knifter/pulsednmr/dist-client/README.TXT

This folder should contain:

 * ./env -> A (virtual, use miniconda) python 3 environment as a whole with:
	- python 3 (3.7)
	- matplotlib 3 (3.0.3)
	- PyQt 5 (5.9.2 with Qt 5.9.7)
	- numpy (1.16.2)
 * putty.exe
 * WinSCP.exe
