knifter/pulsednmr/Documentation/SwitchFilters_2019-06-03T15_28_03.pdf

## Measurement: Transmission / Reflection

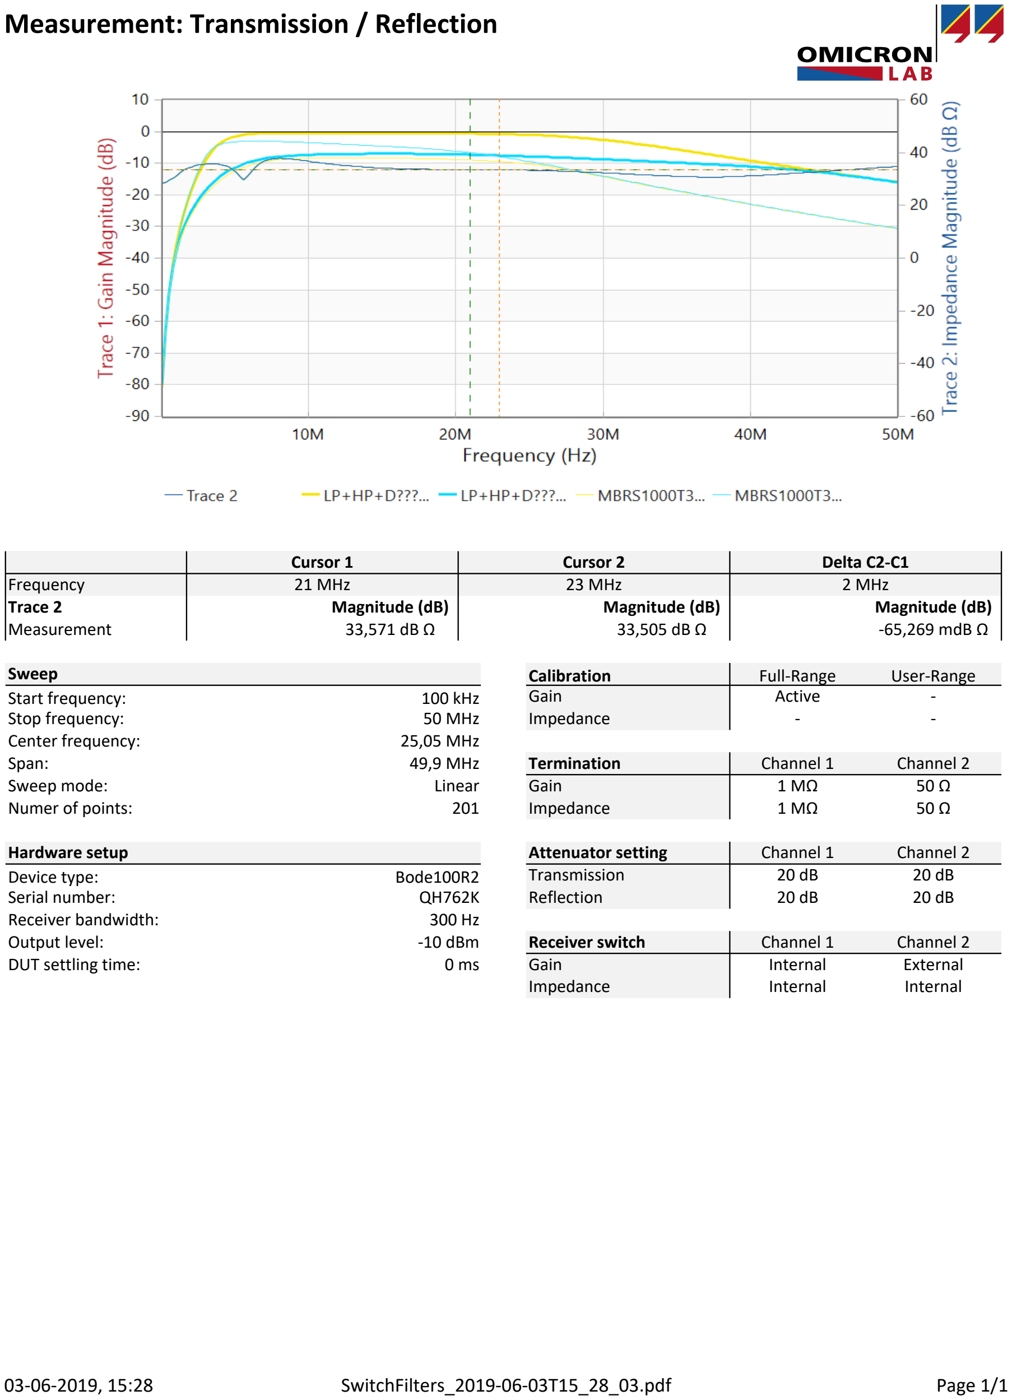
[picture p1: page 1]

03-06-2019, 15:28 | SwitchFilters_2019-06-03T15_28_03.pdf | Page 1/1
Cursor 1 | Cursor 2 | Delta C2-C1
Frequency | 21 MHz | 23 MHz | 2 MHz
Trace 2 | Magnitude (dB) | Magnitude (dB) | | Magnitude (dB)
Measurement | 33,571 dB Ω | 33,505 dB Ω | | -65,269 mdB Ω
Sweep | | Calibration | Full-Range | User-Range
Start frequency: | 100 kHz | Gain | Active | -
Stop frequency: | 50 MHz | Impedance | - | -
Center frequency: | 25,05 MHz
Span: | 49,9 MHz | Termination | Channel 1 | Channel 2
Sweep mode: | Linear | Gain | 1 MΩ | 50 Ω
Numer of points: | 201 | Impedance | 1 MΩ | 50 Ω
Hardware setup | | Attenuator setting | Channel 1 | Channel 2
Device type: | Bode100R2 | Transmission | 20 dB | 20 dB
Serial number: | QH762K | Reflection | 20 dB | 20 dB
Receiver bandwidth: | 300 Hz
Output level: | -10 dBm | Receiver switch | Channel 1 | Channel 2
DUT settling time: | 0 ms | Gain | Internal | External
| | Impedance | Internal | Internal
