knifter/pulsednmr/Bode/20N Packed, Spaced, Toroid_2019-05-02T14_10_56.pdf

## Measurement: Impedance Adapter

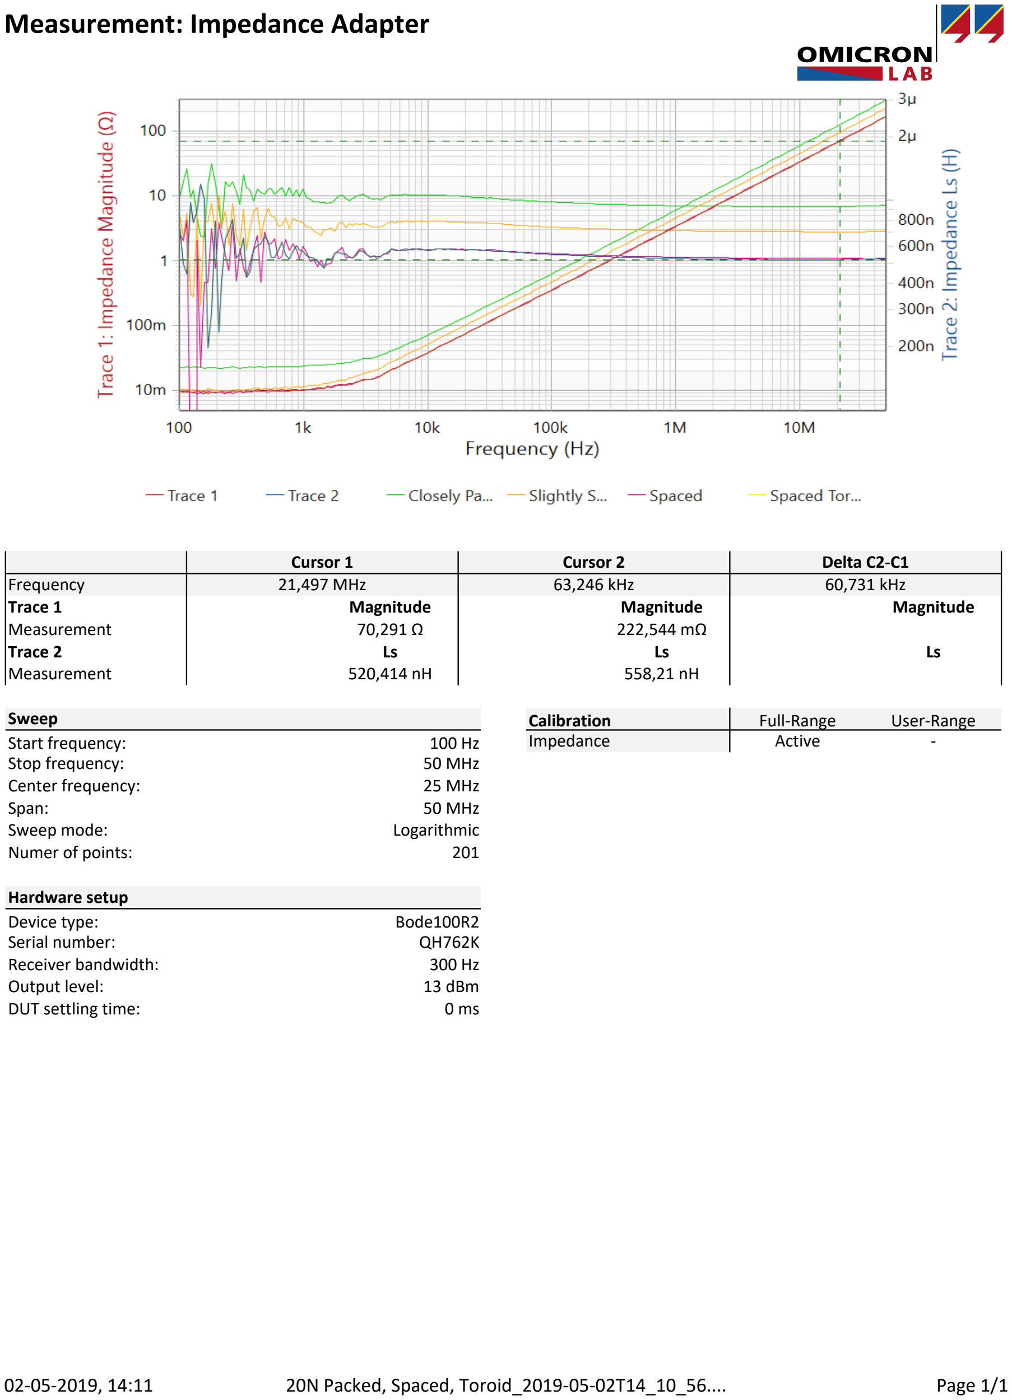
[picture p2: page 1]

02-05-2019, 14:11 | 20N Packed, Spaced, Toroid_2019-05-02T14_10_56.... | Page 1/1
Cursor 1 | Cursor 2 | Delta C2-C1
Frequency | 21,497 MHz | 63,246 kHz | 60,731 kHz
Trace 1 | Magnitude | Magnitude | Magnitude
Measurement | 70,291 Ω | 222,544 mΩ
Trace 2 | Ls | Ls | Ls
Measurement | 520,414 nH | 558,21 nH
Sweep | | Calibration | Full-Range | User-Range
Start frequency: | 100 Hz | Impedance | Active | -
Stop frequency: | 50 MHz
Center frequency: | 25 MHz
Span: | 50 MHz
Sweep mode: | Logarithmic
Numer of points: | 201

Hardware setup
Device type: | Bode100R2
Serial number: | QH762K
Receiver bandwidth: | 300 Hz
Output level: | 13 dBm
DUT settling time: | 0 ms
