knifter/pulsednmr/Bode/20N Packed, Spaced, Toroid_2019-05-02T14_21_03.pdf

## Measurement: Impedance Adapter

Page 1 / 3 | 20N Packed, Spaced, Toroid_2019-05-02T14_21_03.... | 02-05-2019 - 14:21

<!#auto page breaks>
CursorTable: Trace Version Wide | x
Cursor 1 | Cursor 2 | Delta C2-C1
Trace 1 | Magnitude | Magnitude | Magnitude
Measurement | 70,291 Ω | 222,544 mΩ
Trace 2 | Ls | Ls | Ls
Measurement | 520,414 nH | 558,21 nH
Cursor 1 | Cursor 2 | Delta C2-C1
Frequency | 21,497 MHz | | 63,246 kHz | | 60,731 kHz
Measurement | | 70,291 Ω | | 222,544 mΩ
Trace 2 | | Ls | | Ls | | Ls
Measurement | | 520,414 nH | | 558,21 nH
Trace 1 | Magnitude | Magnitude | Magnitude

Settings
Sweep
Start frequency: | 100 Hz
Stop frequency: | 50 MHz
Center frequency: | 25 MHz
Span: | 50 MHz
Sweep mode: | Logarithmic
Numer of points: | 201

Hardware setup
Device type: | Bode100R2
Serial number: | QH762K
Receiver bandwidth: | 300 Hz
Output level: | 13 dBm
DUT settling time: | 0 ms

Single / FIXED
Measurement
Source frequency: | 100 kHz
Measurement: | Impedance
Grid: | Cartesian
Format | Values

Shaped Level (False)

Shaped level | Frequency | Delta | Output level

Page 2 / 3 | 20N Packed, Spaced, Toroid_2019-05-02T14_21_03.... | 02-05-2019 - 14:21

MeasurementModeInUse: Impedance

Attenuator setting | Channel 1 | Channel 2
Reflection | 0 dB | 0 dB | Receiver switch | Channel 1 | Channel 2
| | | Gain | External | External
Attenuator setting | Channel 1 | Channel 2
Transmission | 0 dB | 0 dB | Receiver switch | Channel 1 | Channel 2
| | | Impedance | External | External
Attenuator setting | Channel 1 | Channel 2
Reflection | 0 dB | 0 dB | Receiver switch | Channel 1 | Channel 2
| | | Gain | External | External
| | | Impedance | External | External
Attenuator setting | Channel 1 | Channel 2
Transmission | 0 dB | 0 dB
Reflection | 0 dB | 0 dB
| | | Termination | Channel 1 | Channel 2
| | | Gain | 1 MΩ | 1 MΩ
Probe factor | Channel 1 | Channel 2
Gain | 1: 1 | 1: 1 | Termination | Channel 1 | Channel 2
| | | Impedance | 1 MΩ | 1 MΩ
Probe factor | Channel 1 | Channel 2
Impedance | 1: 1 | 1: 1 | Termination | Channel 1 | Channel 2
| | | Gain | 1 MΩ | 1 MΩ
| | | Impedance | 1 MΩ | 1 MΩ
Probe factor | Channel 1 | Channel 2
Gain | 1: 1 | 1: 1
Impedance | 1: 1 | 1: 1

Calibration: MAIN & MULTI
Calibration | Full-Range | User-Range
Gain | - | -
Impedance | Active | -
Calibration | Full-Range | User-Range
Thru | - | -
O/S/L | Active | -

Calibration: MULTI or MAIN
Calibration | Full-Range | User-Range
Impedance | Active | -

Calibration: Extrapolated
GainFullExtrapolated:
ImpFullExtrapolated:
Calibration | Full-Range | User-Range
Impedance | Active | -

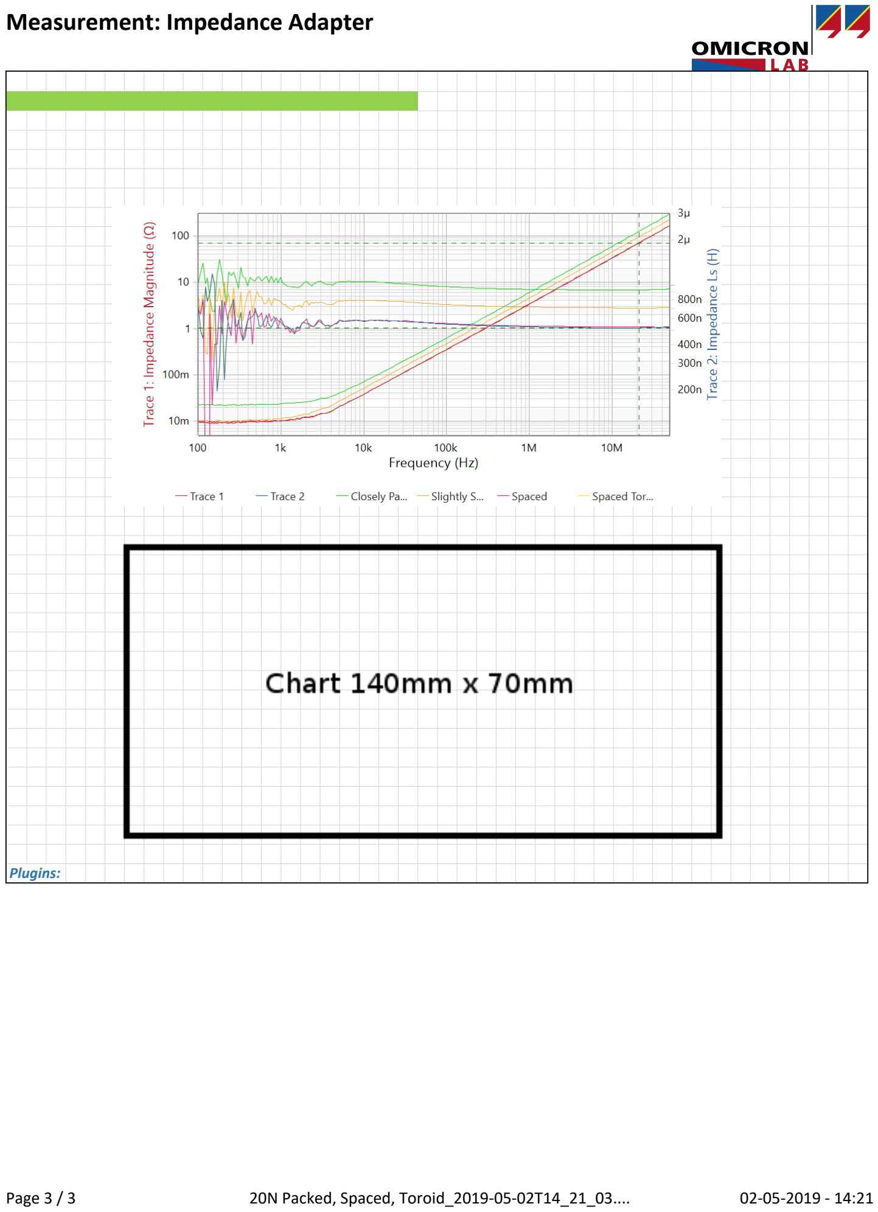
[picture p3: page 3]

Page 3 / 3 | 20N Packed, Spaced, Toroid_2019-05-02T14_21_03.... | 02-05-2019 - 14:21

Plugins:
