knifter/pulsednmr/Bode/20N Packed, Spaced, Toroid_2019-05-02T14_22_00.pdf

## Measurement: Impedance Adapter

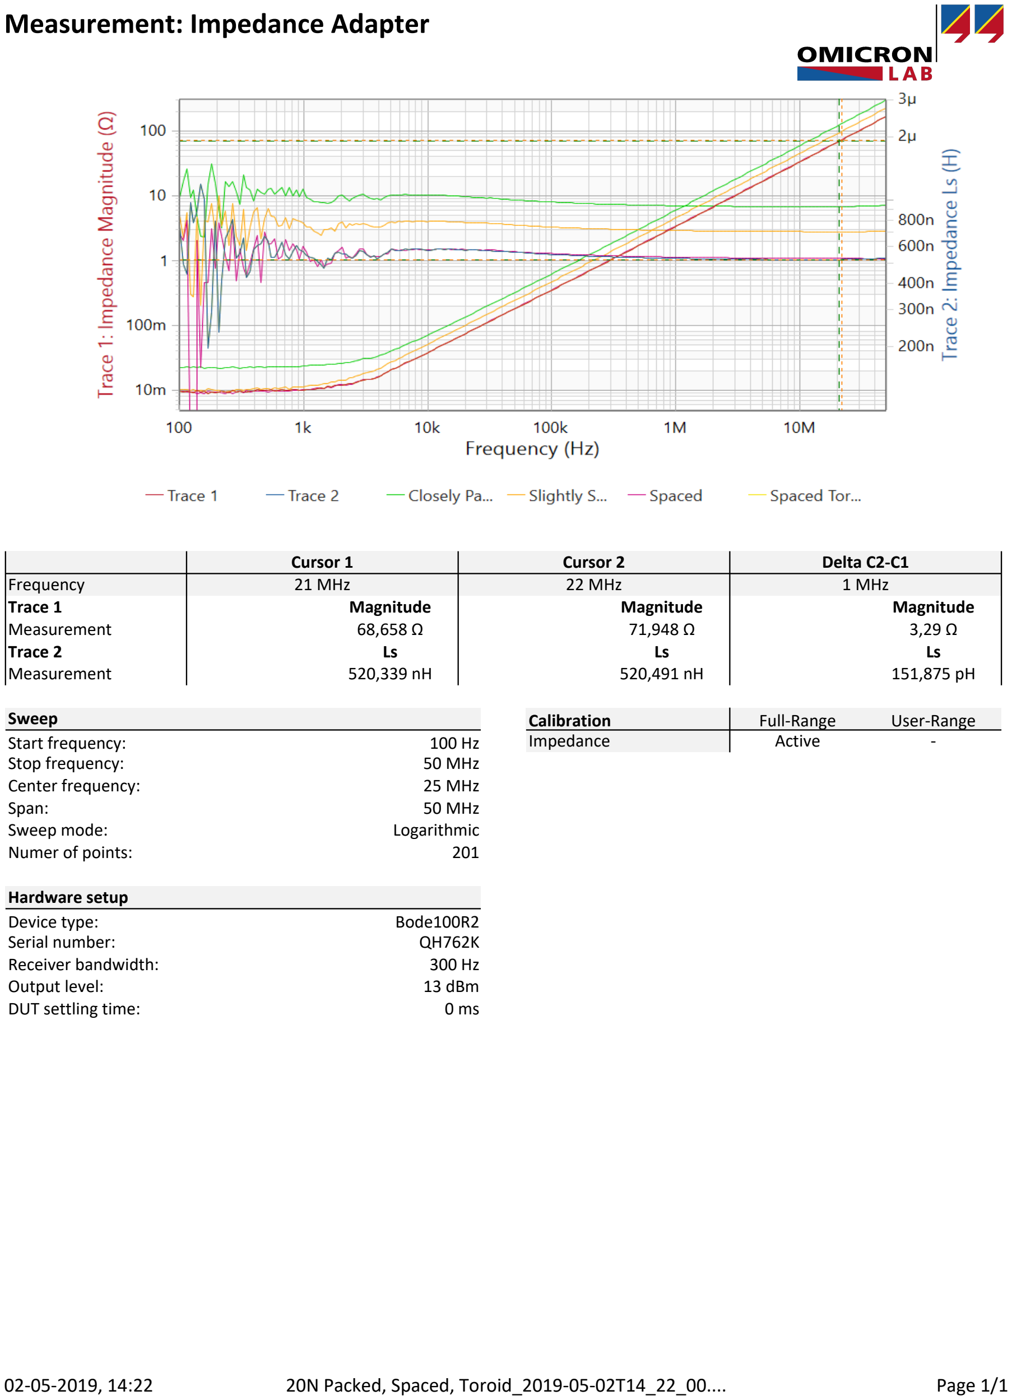
[picture p4: page 1]

02-05-2019, 14:22 | 20N Packed, Spaced, Toroid_2019-05-02T14_22_00.... | Page 1/1
Cursor 1 | Cursor 2 | Delta C2-C1
Frequency | 21 MHz | 22 MHz | 1 MHz
Trace 1 | Magnitude | Magnitude | Magnitude
Measurement | 68,658 Ω | 71,948 Ω | 3,29 Ω
Trace 2 | Ls | Ls | Ls
Measurement | 520,339 nH | 520,491 nH | 151,875 pH
Sweep | | Calibration | Full-Range | User-Range
Start frequency: | 100 Hz | Impedance | Active | -
Stop frequency: | 50 MHz
Center frequency: | 25 MHz
Span: | 50 MHz
Sweep mode: | Logarithmic
Numer of points: | 201

Hardware setup
Device type: | Bode100R2
Serial number: | QH762K
Receiver bandwidth: | 300 Hz
Output level: | 13 dBm
DUT settling time: | 0 ms
