knifter/pulsednmr/Bode/AMP1_2019-04-16b.pdf

## Measurement: Transmission / Reflection

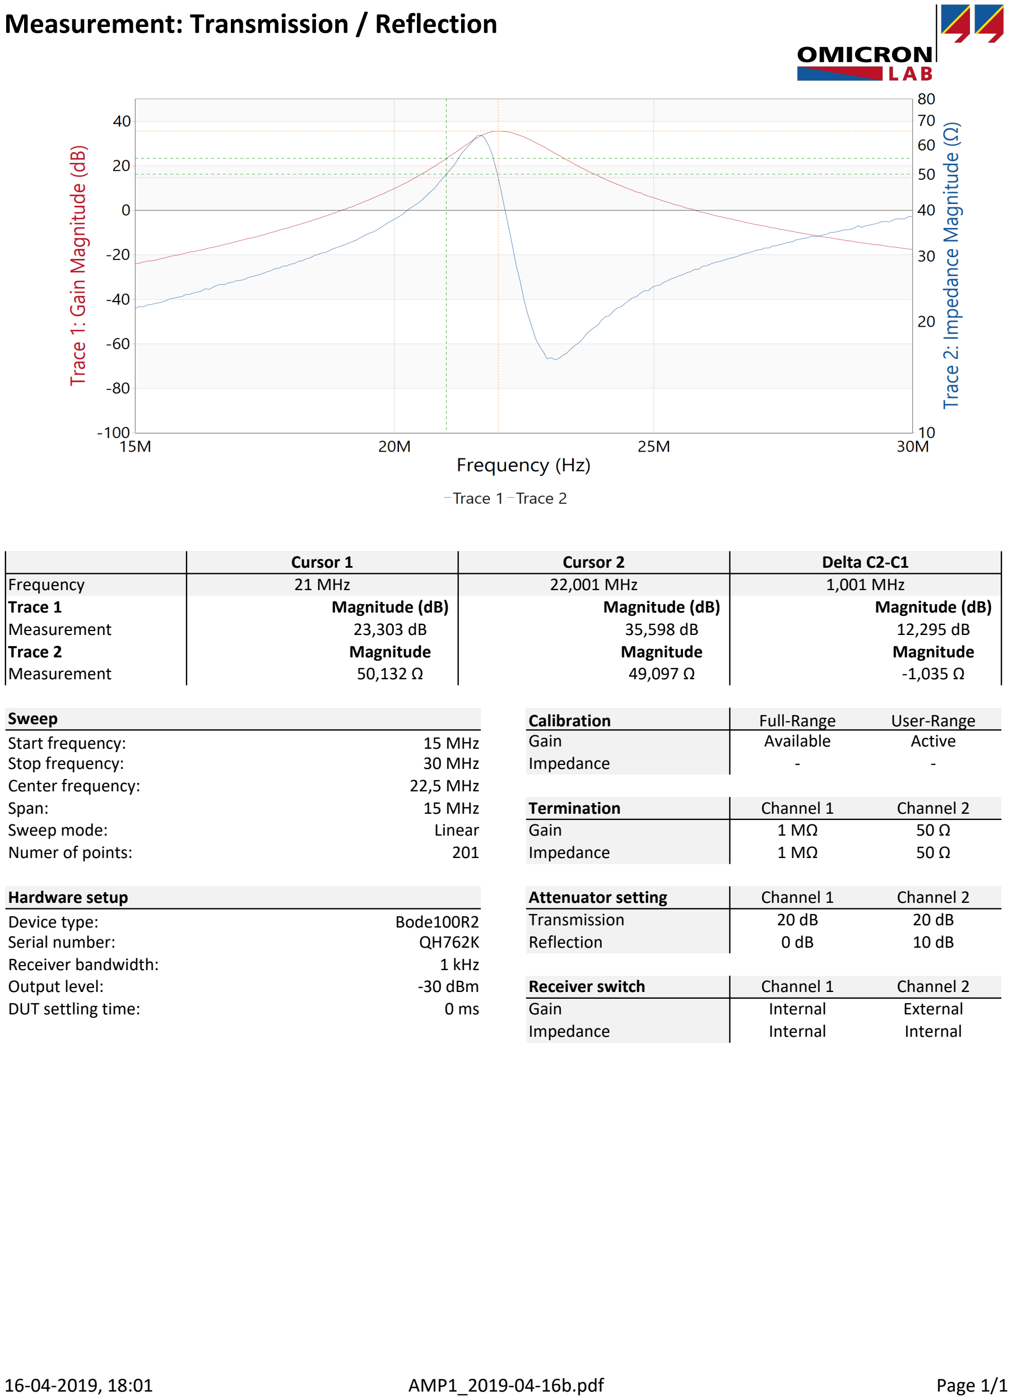
[picture p5: page 1]

16-04-2019, 18:01 | AMP1_2019-04-16b.pdf | Page 1/1
Cursor 1 | Cursor 2 | Delta C2-C1
Frequency | 21 MHz | 22,001 MHz | 1,001 MHz
Trace 1 | Magnitude (dB) | Magnitude (dB) | | Magnitude (dB)
Measurement | 23,303 dB | 35,598 dB | | 12,295 dB
Trace 2 | Magnitude | Magnitude | | Magnitude
Measurement | 50,132 Ω | 49,097 Ω | | -1,035 Ω
Sweep | | Calibration | Full-Range | User-Range
Start frequency: | 15 MHz | Gain | Available | Active
Stop frequency: | 30 MHz | Impedance | - | -
Center frequency: | 22,5 MHz
Span: | 15 MHz | Termination | Channel 1 | Channel 2
Sweep mode: | Linear | Gain | 1 MΩ | 50 Ω
Numer of points: | 201 | Impedance | 1 MΩ | 50 Ω
Hardware setup | | Attenuator setting | Channel 1 | Channel 2
Device type: | Bode100R2 | Transmission | 20 dB | 20 dB
Serial number: | QH762K | Reflection | 0 dB | 10 dB
Receiver bandwidth: | 1 kHz
Output level: | -30 dBm | Receiver switch | Channel 1 | Channel 2
DUT settling time: | 0 ms | Gain | Internal | External
| | Impedance | Internal | Internal
