knifter/pulsednmr/Bode/RF Amp 4W 2019-05-10.pdf

## Measurement: Transmission / Reflection

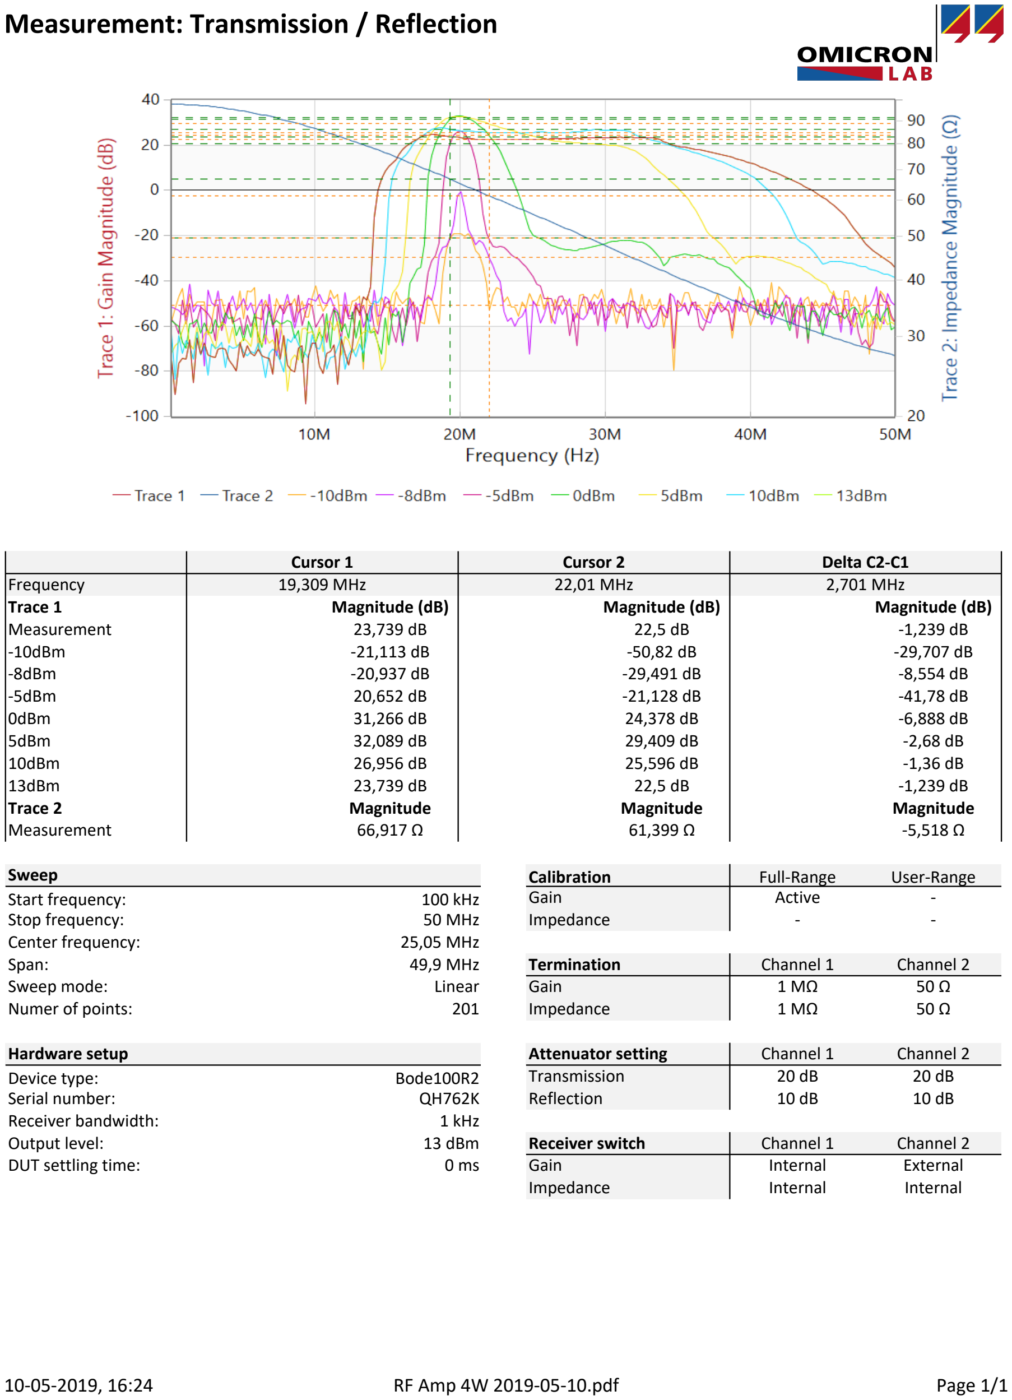
[picture p8: page 1]

10-05-2019, 16:24 | RF Amp 4W 2019-05-10.pdf | Page 1/1
Cursor 1 | Cursor 2 | Delta C2-C1
Frequency | 19,309 MHz | 22,01 MHz | 2,701 MHz
Trace 1 | Magnitude (dB) | Magnitude (dB) | | Magnitude (dB)
Measurement | 23,739 dB | 22,5 dB | | -1,239 dB
-10dBm | -21,113 dB | -50,82 dB | | -29,707 dB
-8dBm | -20,937 dB | -29,491 dB | | -8,554 dB
-5dBm | 20,652 dB | -21,128 dB | | -41,78 dB
0dBm | 31,266 dB | 24,378 dB | | -6,888 dB
5dBm | 32,089 dB | 29,409 dB | | -2,68 dB
10dBm | 26,956 dB | 25,596 dB | | -1,36 dB
13dBm | 23,739 dB | 22,5 dB | | -1,239 dB
Trace 2 | Magnitude | Magnitude | | Magnitude
Measurement | 66,917 Ω | 61,399 Ω | | -5,518 Ω
Sweep | | Calibration | Full-Range | User-Range
Start frequency: | 100 kHz | Gain | Active | -
Stop frequency: | 50 MHz | Impedance | - | -
Center frequency: | 25,05 MHz
Span: | 49,9 MHz | Termination | Channel 1 | Channel 2
Sweep mode: | Linear | Gain | 1 MΩ | 50 Ω
Numer of points: | 201 | Impedance | 1 MΩ | 50 Ω
Hardware setup | | Attenuator setting | Channel 1 | Channel 2
Device type: | Bode100R2 | Transmission | 20 dB | 20 dB
Serial number: | QH762K | Reflection | 10 dB | 10 dB
Receiver bandwidth: | 1 kHz
Output level: | 13 dBm | Receiver switch | Channel 1 | Channel 2
DUT settling time: | 0 ms | Gain | Internal | External
| | Impedance | Internal | Internal
