knifter/pulsednmr/(list of files, cad)

Other CAD files:
3D/PassiveSwitchCase.ipt
