knifter/pulsednmr/Documentation/Jason Allen-Poster.pdf

# Jason

# Allen

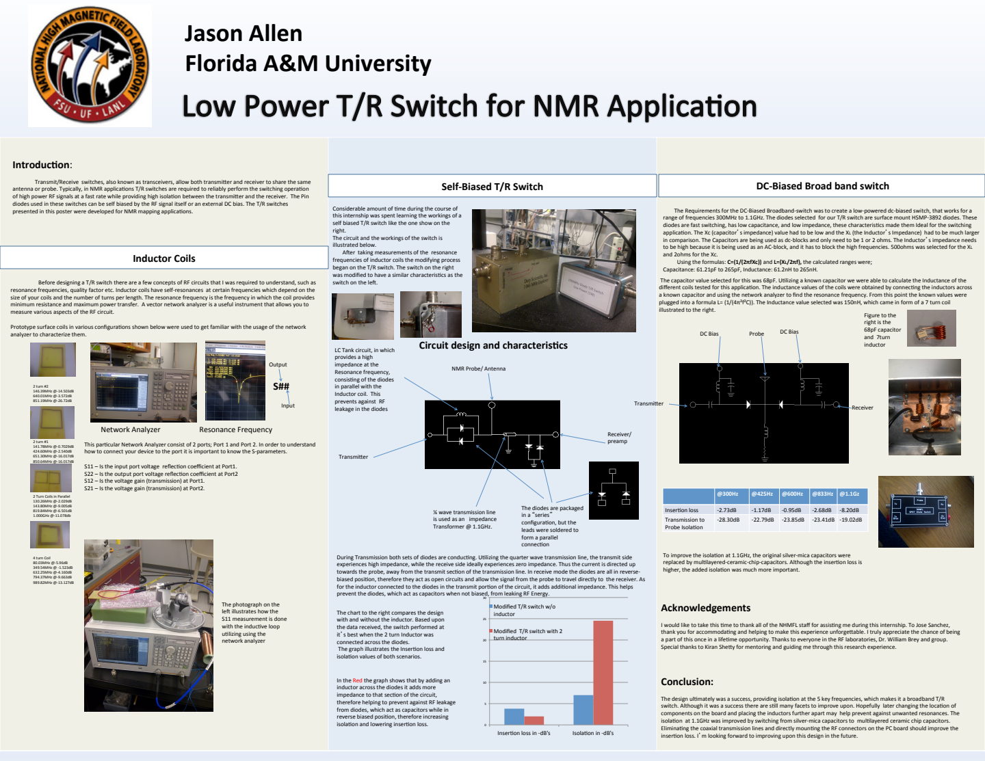
[picture p11: page 1]
Florida; University; Introduc7on:; Transmit/Receive; switches,; also; known; transceivers,; allow; both; transmi7er; and; receiver; share; the; same; antenna; probe.; Typically,; NMR; applica>ons; switches; are; required; reliably; perform; switching; opera>on; high; power; signals; fast; rate; while; providing; isola>on; between; receiver.; The; Pin; diodes; used; these; can; self; biased; signal; itself; external; bias.; presented; this; poster; were; developed; for; mapping; applica>ons.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

Insertion loss | -‐2.73dB | -‐1.17dB | -‐0.95dB | -‐2.68dB | -‐8.20dB
Transmission to Probe Isolation | -‐28.30dB | -‐22.79dB | -‐23.85dB | -‐23.41dB | -‐19.02dB

isolation
multilayered-‐ceramic-‐chip-‐capacitors.
