knifter/pulsednmr/Documentation/Red_Pitaya_Schematics_v1.0.1.pdf

1

2

3

4

5

6

D | D
B | B
C | C
A | A
Designer: B.B., B.R., Z.L. | Document: | Red_Pitaya_Schematics_v1.0.1 | Sheet 1 of 9
Drawn By: Z.L. | Modif. Date: | 6.3.2014 | SCHEMATIC
Approved By: R.U. | Print Date: | 6.3.2014 | Size: A4 H

# Red Pitaya

# Electrical schematics for:

# Red Pitaya

# version: variant: Release1

V1.0.1

Red Pitaya d.o.o.

# Velika pot 22 5250 Solkan Slovenia

# www.redpitaya.com

# name:

Copyright 2014, Red Pitaya d.o.o. All Rights Reserved.
By exception, this version of document may be freely reproduced, distributed, republished, displayed, posted, transmitted or copied in any form or by any means, as is without modifications in its contents, without the prior written permission of Red Pitaya d.o.o.
Red Pitaya and the Red Pitaya logo are registered trademarks of Red Pitaya d.o.o. All trademarks and trade names are the properties of their respective owners and Red Pitaya d.o.o. disclaims any proprietary interest or right in trademarks, service marks and trade names other than its own.
Red Pitaya is not responsible for typographical or other errors or omissions or for direct, indirect, incidental or consequential damages related to this material or resulting from its use.
Red Pitaya makes no warranty or representation respecting this material, which is provided on an "AS IS" basis.
RED PITAYA HEREBY DISCLAIMS ALL WARRANTIES OR LIABILITY OF ANY KIND WITH RESPECT THERETO, INCLUDING, WITHOUT LIMITATION, REPRESENTATIONS REGARDING ACCURACY AND COMPLETENESS, ALL IMPLIED WARRANTIES AND CONDITIONS OF MERCHANTABILITY, SUITABILITY OR FITNESS FOR A PARTICULAR PURPOSE, TITLE AND/OR NON-INFRINGEMENT.
This material is not designed, intended or authorized for use in any applications in which the failure of the product could result in personal injury, death or property damage.
Any party using or selling products for use in any such applications do so at their sole risk and agree that Red Pitaya is not liable, in whole or in part, for any claim or damage arising from such use, and agree to fully indemnify, defend and hold harmless Red Pitaya from and against any and all claims, damages, loss, cost, expense or liability arising out of or in connection with the use or performance of products in such applications.

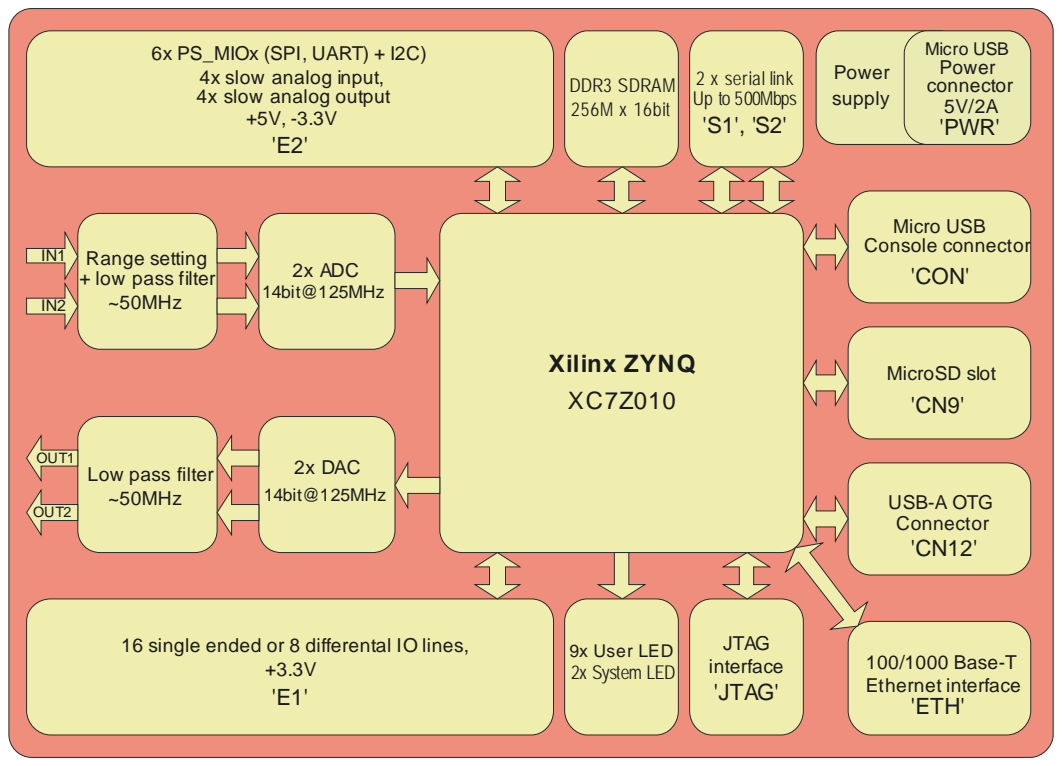
[picture p12: page 2]
DDR3 SDRAM 256M x 16bit; Range setting + low pass filter ~50MHz; 2x ADC 14bit@125MHz; Xilinx ZYNQ XC7Z010; Low pass filter ~50MHz; OUT1; OUT2; 2x DAC 14bit@125MHz; 2 x serial link Up to 500Mbps 'S1', 'S2'; Micro USB Console connector 'CON'; MicroSD slot 'CN9'; USB-A OTG Connector 'CN12'; 100/1000 Base-T Ethernet interface 'ETH'; JTAG; 'JTAG'; 9x User LED; 2x System LED; interface; supply; Power; Micro USB Power connector 5V/2A 'PWR'

6x PS_MIOx (SPI, UART) + I2C)
4x slow analog input,
4x slow analog output

16 single ended or 8 differental IO lines,

Designer: B.B., B.R., Z.L. | Document: | Red_Pitaya_Schematics_v1.0.1 | Sheet 2 of 9
Drawn By: Z.L. | Modif. Date: | 6.3.2014 | SCHEMATIC

Red Pitaya v1.0 block schematics

LV
IO_25_34 T19 | IO_L24N_T3_34 P16 | IO_L24P_T3_34 P15 | IO_L23N_T3_34 P18 | IO_L23P_T3_34 N17 | IO_L22N_T3_34 W19 | IO_L22P_T3_34 W18 | IO_L21N_T3_DQS_34 V18 | IO_L21P_T3_DQS_34 V17 | IO_L20N_T3_34 R18 | IO_L20P_T3_34 T17 | IO_L19N_T3_VREF_34 R17 | IO_L19P_T3_34 R16 | IO_L18N_T2_34 W16 | IO_L18P_T2_34 V16 | IO_L17N_T2_34 Y19 | IO_L17P_T2_34 Y18 | IO_L16N_T2_34 W20 | IO_L16P_T2_34 V20 | IO_L15N_T2_DQS_34 U20 | IO_L15P_T2_DQS_34 T20 | IO_L14N_T2_SRCC_34 P20 | IO_L14P_T2_SRCC_34 N20 | IO_L13N_T2_MRCC_34 P19 | IO_L13P_T2_MRCC_34 N18 | IO_L12N_T1_MRCC_34 U19 | IO_L12P_T1_MRCC_34 U18 | IO_L11N_T1_SRCC_34 U15 | IO_L11P_T1_SRCC_34 U14 | IO_L10N_T1_34 W15 | IO_L10P_T1_34 V15 | IO_L9N_T1_DQS_34 U17 | IO_L9P_T1_DQS_34 T16 | IO_L8N_T1_34 Y14 | IO_L8P_T1_34 W14 | IO_L7N_T1_34 Y17 | IO_L7P_T1_34 Y16 | IO_L6N_T0_VREF_34 R14 | IO_L6P_T0_34 P14 | IO_L5N_T0_34 T15 | IO_L5P_T0_34 T14 | IO_L4N_T0_34 W13 | IO_L4P_T0_34 V12 | IO_L3N_T0_DQS_34 V13 | IO_L3P_T0_DQS_PUDC_B_34 U13 | IO_L2N_T0_34 U12 | IO_L2P_T0_34 T12 | IO_L1N_T0_34 T10 | IO_L1P_T0_34 T11 | IO_0_34 R19

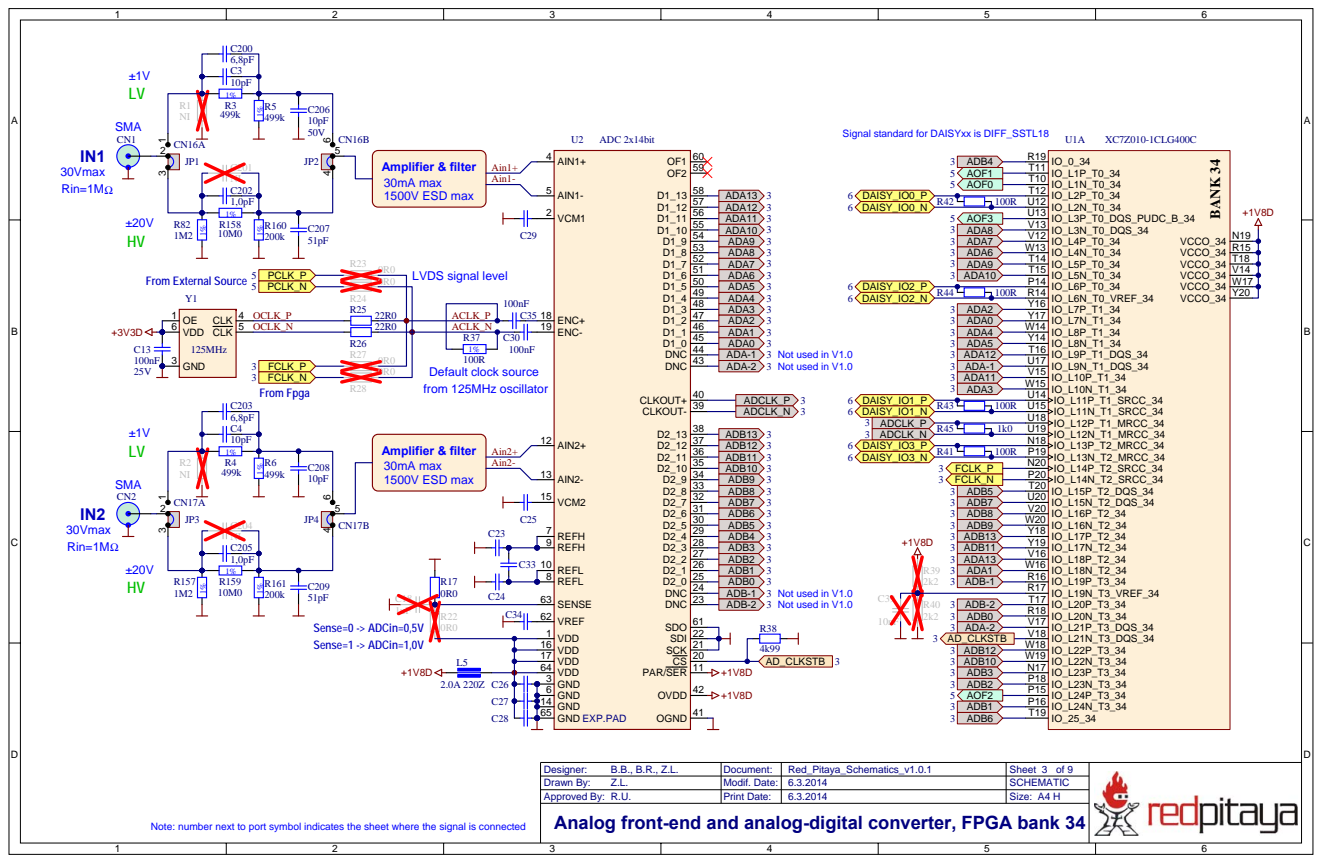
[picture p13: page 3]

Designer: B.B., B.R., Z.L. | Document: | Red_Pitaya_Schematics_v1.0.1 | Sheet 3 of 9
Drawn By: Z.L. | Modif. Date: | 6.3.2014 | SCHEMATIC

Analog front-end and analog-digital converter, FPGA bank 34

Note: number next to port symbol indicates the sheet where the signal is connected

IO_25_35 | J15 IO_L24N_T3_AD15N_35 | J16 IO_L24P_T3_AD15P_35 | K16 IO_L23N_T3_35 | M15 IO_L23P_T3_35 | M14 IO_L22N_T3_AD7N_35 | L15 IO_L22P_T3_AD7P_35 | L14 IO_L21N_T3_DQS_AD14N_35 | N16 IO_L21P_T3_DQS_AD14P_35 | N15 IO_L20N_T3_AD6N_35 | J14 IO_L20P_T3_AD6P_35 | K14 IO_L19N_T3_VREF_35 | G15 IO_L19P_T3_35 | H15 IO_L18N_T2_AD13N_35 | G20 IO_L18P_T2_AD13P_35 | G19 IO_L17N_T2_AD5N_35 | H20 IO_L17P_T2_AD5P_35 | J20 IO_L16N_T2_35 | G18 IO_L16P_T2_35 | G17 IO_L15N_T2_DQS_AD12N_35 | F20 IO_L15P_T2_DQS_AD12P_35 | F19 IO_L14N_T2_AD4N_SRCC_35 | H18 IO_L14P_T2_AD4P_SRCC_35 | J18 IO_L13N_T2_MRCC_35 | H17 IO_L13P_T2_MRCC_35 | H16 IO_L12N_T1_MRCC_35 | K18 IO_L12P_T1_MRCC_35 | K17 IO_L11N_T1_SRCC_35 | L17 IO_L11P_T1_SRCC_35 | L16 IO_L10N_T1_AD11N_35 | J19 IO_L10P_T1_AD11P_35 | K19 IO_L9N_T1_DQS_AD3N_35 | L20 IO_L9P_T1_DQS_AD3P_35 | L19 IO_L8N_T1_AD10N_35 | M18 IO_L8P_T1_AD10P_35 | M17 IO_L7N_T1_AD2N_35 | M20 IO_L7P_T1_AD2P_35 | M19 IO_L6N_T0_VREF_35 | F17 IO_L6P_T0_35 | F16 IO_L5N_T0_AD9N_35 | E19 IO_L5P_T0_AD9P_35 | E18 IO_L4N_T0_35 | D20 IO_L4P_T0_35 | D19 IO_L3N_T0_DQS_AD1N_35 | D18 IO_L3P_T0_DQS_AD1P_35 | E17 IO_L2N_T0_AD8N_35 | A20 IO_L2P_T0_AD8P_35 | B19 IO_L1N_T0_AD0N_35 | B20 IO_L1P_T0_AD0P_35 | C20 IO_0_35 | G14
DA1 13 | DA2 12 | DA3 11 | DA4 10 | DA5 9 | DA6 8 | DA7 7 | DA8 6 | DA9 5 | DA10 4 | DA11 3 | DA12 2 | DA13 1

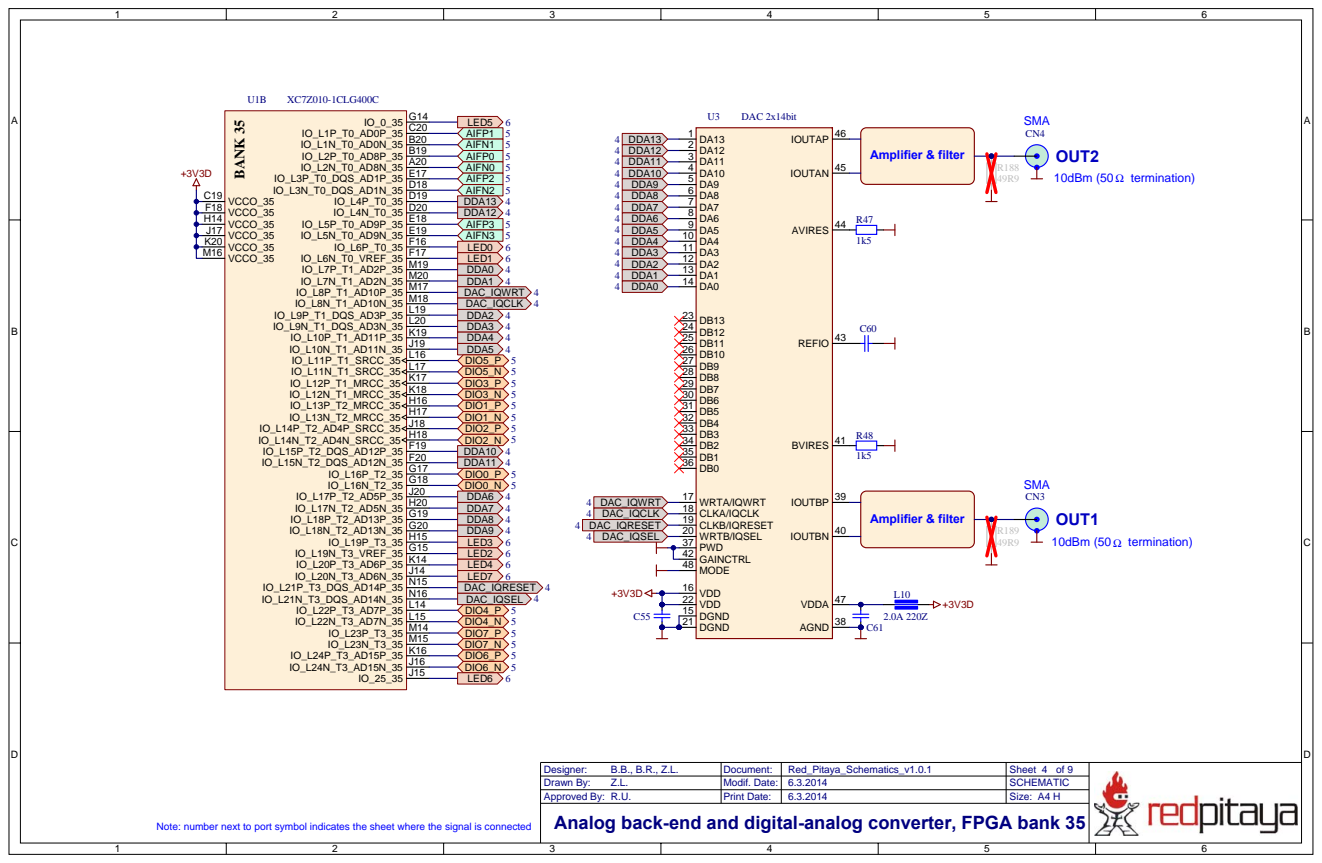
[picture p14: page 4]

Designer: B.B., B.R., Z.L. | Document: | Red_Pitaya_Schematics_v1.0.1 | Sheet 4 of 9
Drawn By: Z.L. | Modif. Date: | 6.3.2014 | SCHEMATIC

Analog back-end and digital-analog converter, FPGA bank 35

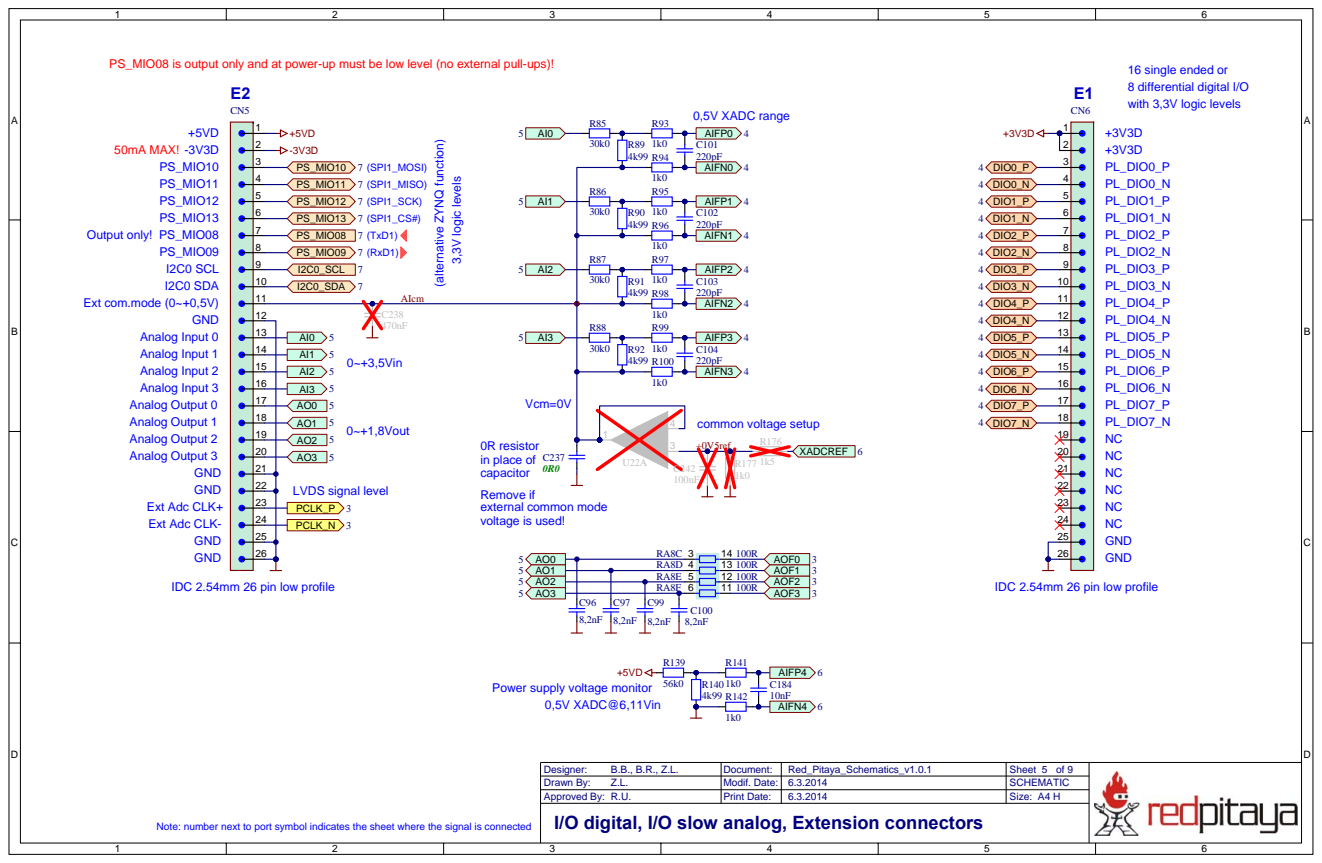
[picture p15: page 5]

with 3,3V logic levels 0,5V XADC range

Power supply voltage monitor

Designer: B.B., B.R., Z.L. | Document: | Red_Pitaya_Schematics_v1.0.1 | Sheet 5 of 9
Drawn By: Z.L. | Modif. Date: | 6.3.2014 | SCHEMATIC

I/O digital, I/O slow analog, Extension connectors

S1

## POW

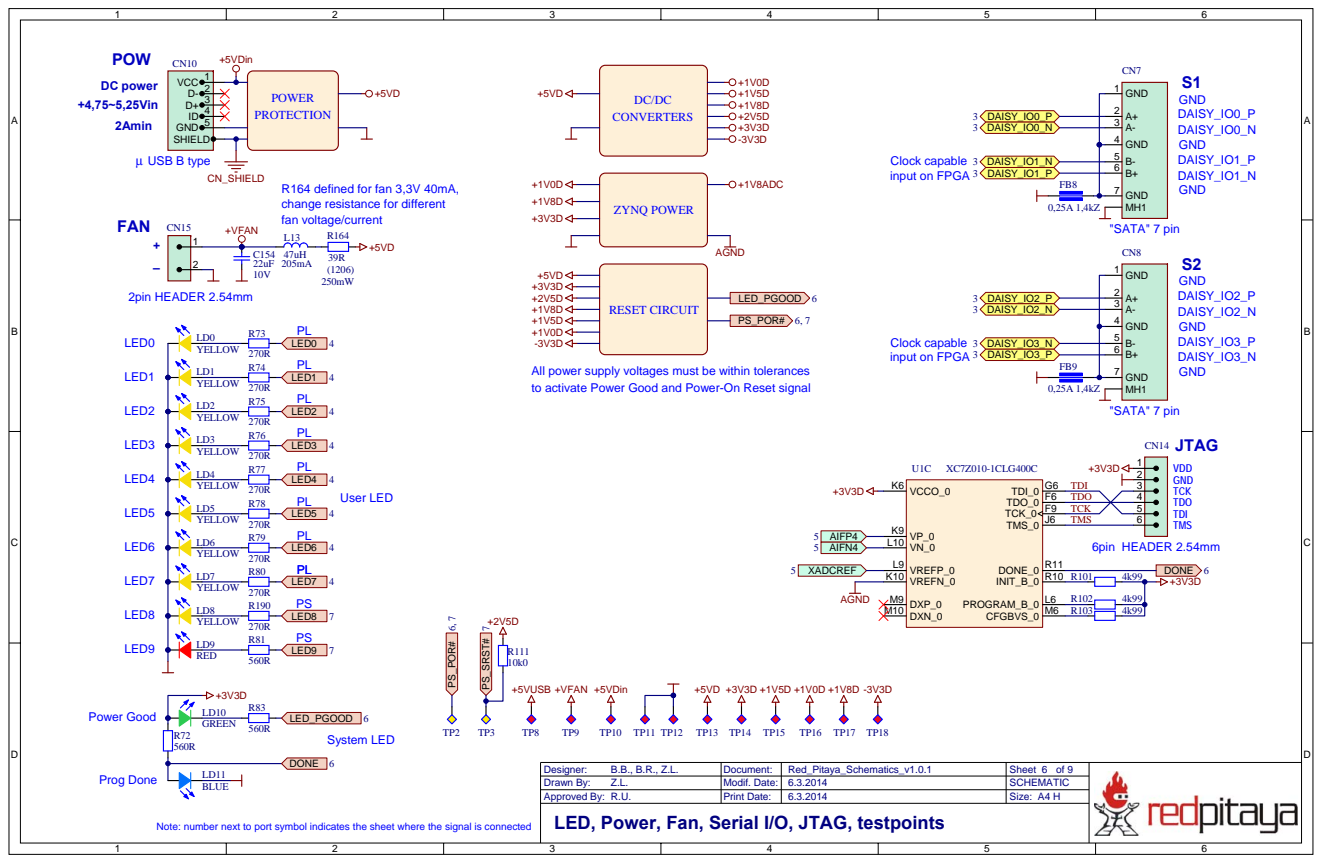
[picture p16: page 6]

R164 defined for fan 3,3V 40mA,
change resistance for different

All power supply voltages must be within tolerances
to activate Power Good and Power-On Reset signal

Designer: B.B., B.R., Z.L. | Document: | Red_Pitaya_Schematics_v1.0.1 | Sheet 6 of 9
Drawn By: Z.L. | Modif. Date: | 6.3.2014 | SCHEMATIC

LED, Power, Fan, Serial I/O, JTAG, testpoints

PS_MIO53_501 | C11 PS_MIO52_501 | C10 PS_MIO51_501 | B9 PS_MIO50_501 | B13 PS_MIO49_501 | C12 PS_MIO48_501 | B12 PS_MIO47_501 | B14 PS_MIO46_501 | D16 PS_MIO45_501 | B15 PS_MIO44_501 | F13 PS_MIO43_501 | A9 PS_MIO42_501 | E12 PS_MIO41_501 | C17 PS_MIO40_501 | D14 PS_MIO39_501 | C18 PS_MIO38_501 | E13 PS_MIO37_501 | A10 PS_MIO36_501 | A11 PS_MIO35_501 | F12 PS_MIO34_501 | A12 PS_MIO33_501 | D15 PS_MIO32_501 | A14 PS_MIO31_501 | E16 PS_MIO30_501 | C15 PS_MIO29_501 | C13 PS_MIO28_501 | C16 PS_MIO27_501 | D13 PS_MIO26_501 | A15 PS_MIO25_501 | F15 PS_MIO24_501 | A16 PS_MIO23_501 | D11 PS_MIO22_501 | B17 PS_MIO21_501 | F14 PS_MIO20_501 | A17 PS_MIO19_501 | D10 PS_MIO18_501 | B18 PS_MIO17_501 | E14 PS_MIO16_501 | A19 PS_MIO15_500 | C8 PS_MIO14_500 | C5 PS_MIO13_500 | E8 PS_MIO12_500 | D9 PS_MIO11_500 | C6 PS_MIO10_500 | E9 PS_MIO9_500 | B5 PS_MIO8_500 | D5 PS_MIO7_500 | D8 PS_MIO6_500 | A5 PS_MIO5_500 | A6 PS_MIO4_500 | B7 PS_MIO3_500 | D6 PS_MIO2_500 | B8 PS_MIO1_500 | A7 PS_MIO0_500 | E6

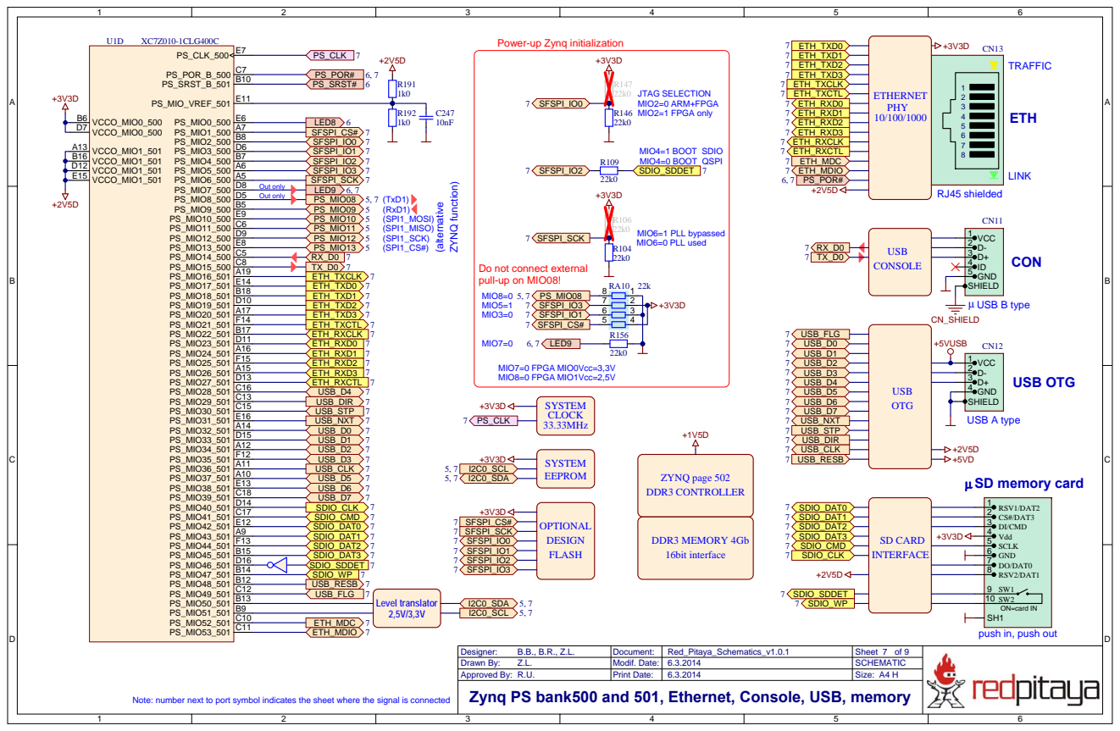
[picture p17: page 7]

Power-up Zynq initialization

Do not connect external
pull-up on MIO08!
MIO8=0

Designer: B.B., B.R., Z.L. | Document: | Red_Pitaya_Schematics_v1.0.1 | Sheet 7 of 9
Drawn By: Z.L. | Modif. Date: | 6.3.2014 | SCHEMATIC

Zynq PS bank500 and 501, Ethernet, Console, USB, memory

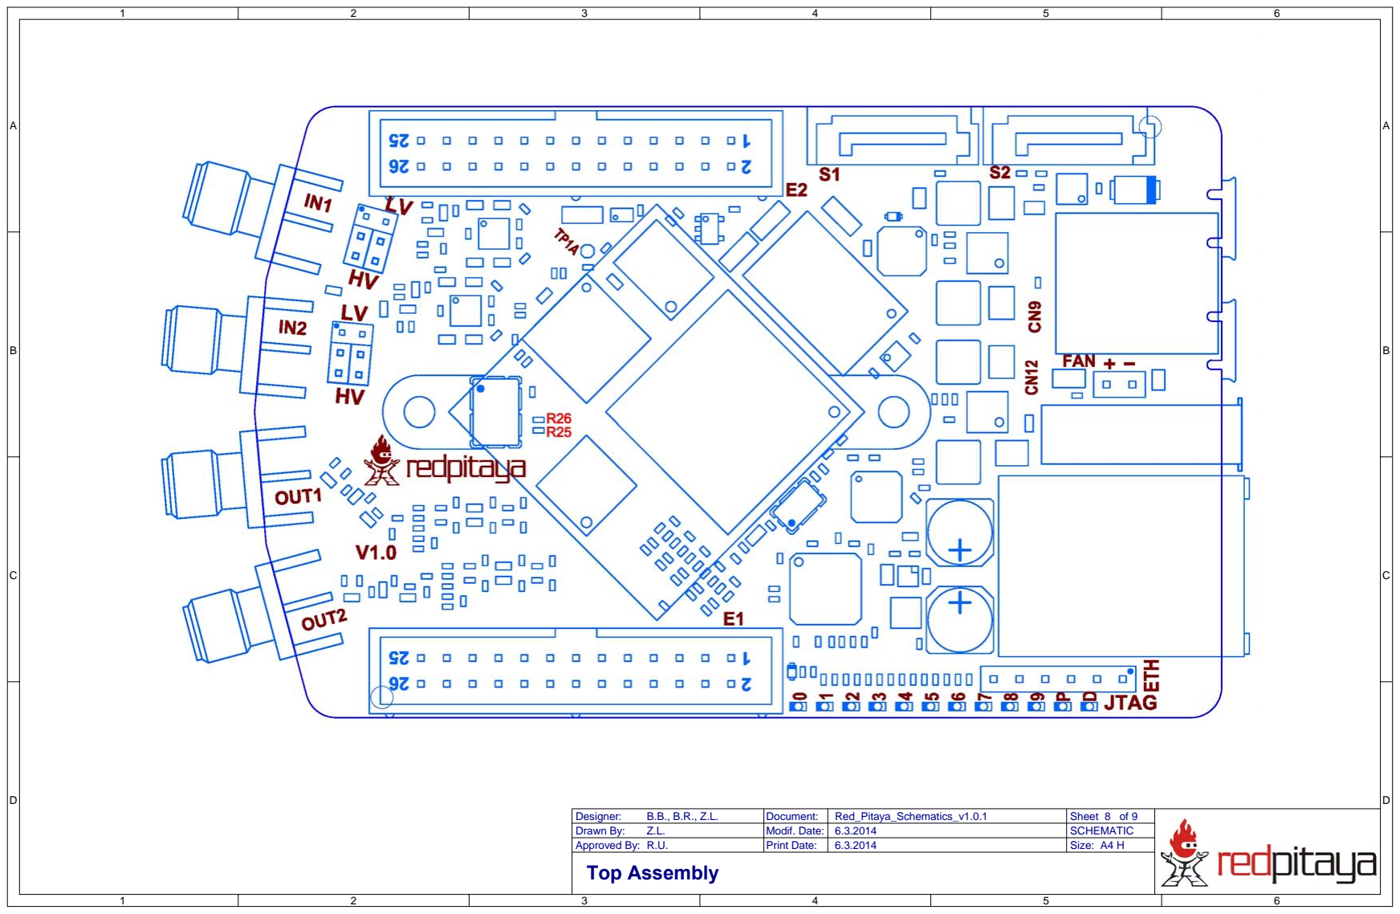
[picture p18: page 8]

1

2

3

4

5

6

D | D
B | B
C | C
A | A

# Top Assembly

Designer: B.B., B.R., Z.L. | Document: | Red_Pitaya_Schematics_v1.0.1 | Sheet 8 of 9
Drawn By: Z.L. | Modif. Date: | 6.3.2014 | SCHEMATIC

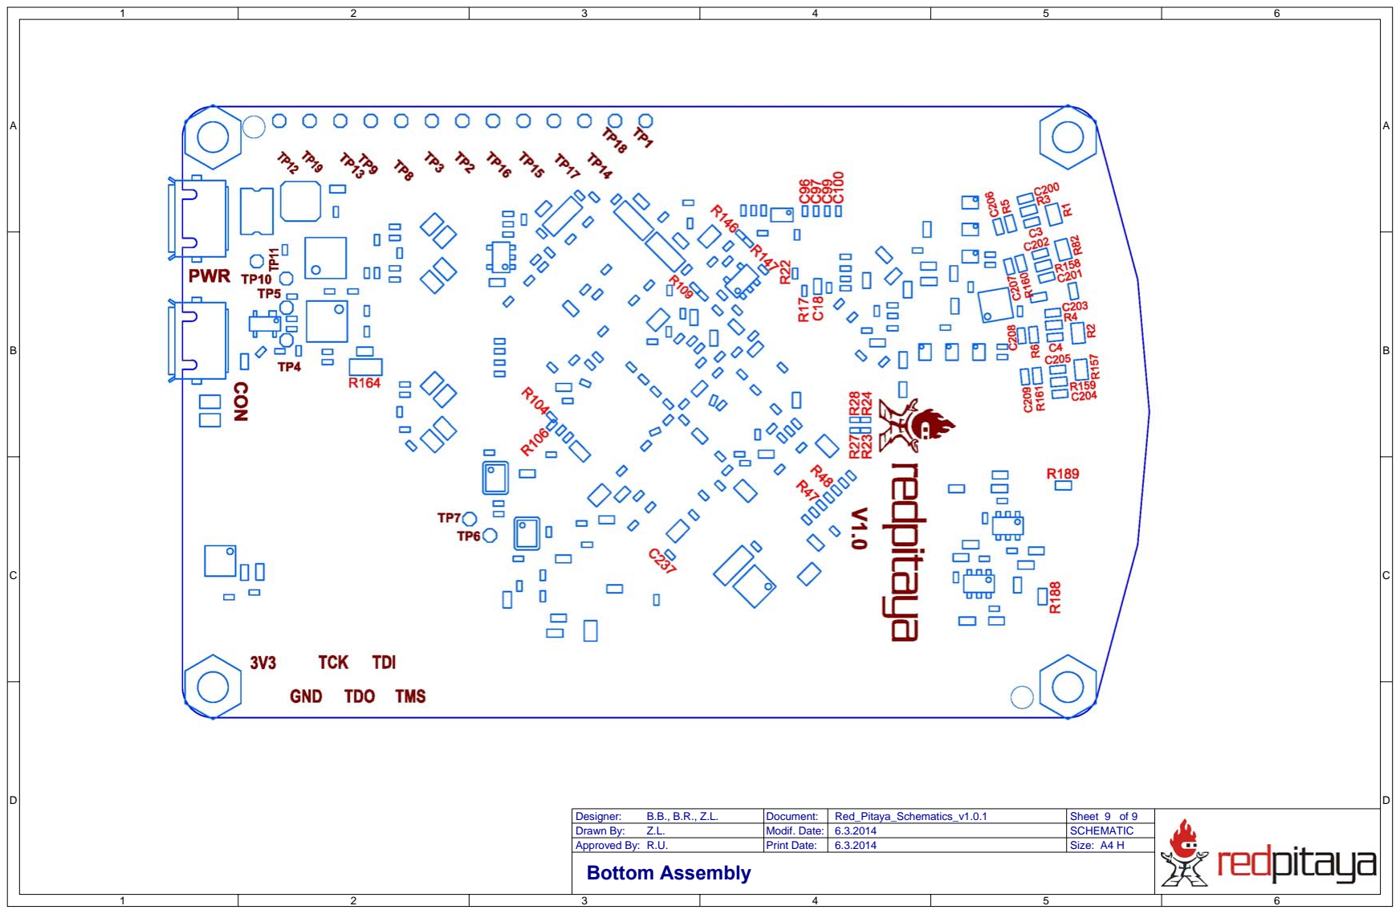
[picture p19: page 9]

1

2

3

4

5

6

D | D
B | B
C | C
A | A

# Bottom Assembly

Designer: B.B., B.R., Z.L. | Document: | Red_Pitaya_Schematics_v1.0.1 | Sheet 9 of 9
Drawn By: Z.L. | Modif. Date: | 6.3.2014 | SCHEMATIC
