knifter/pulsednmr/Documentation/Rplots.pdf

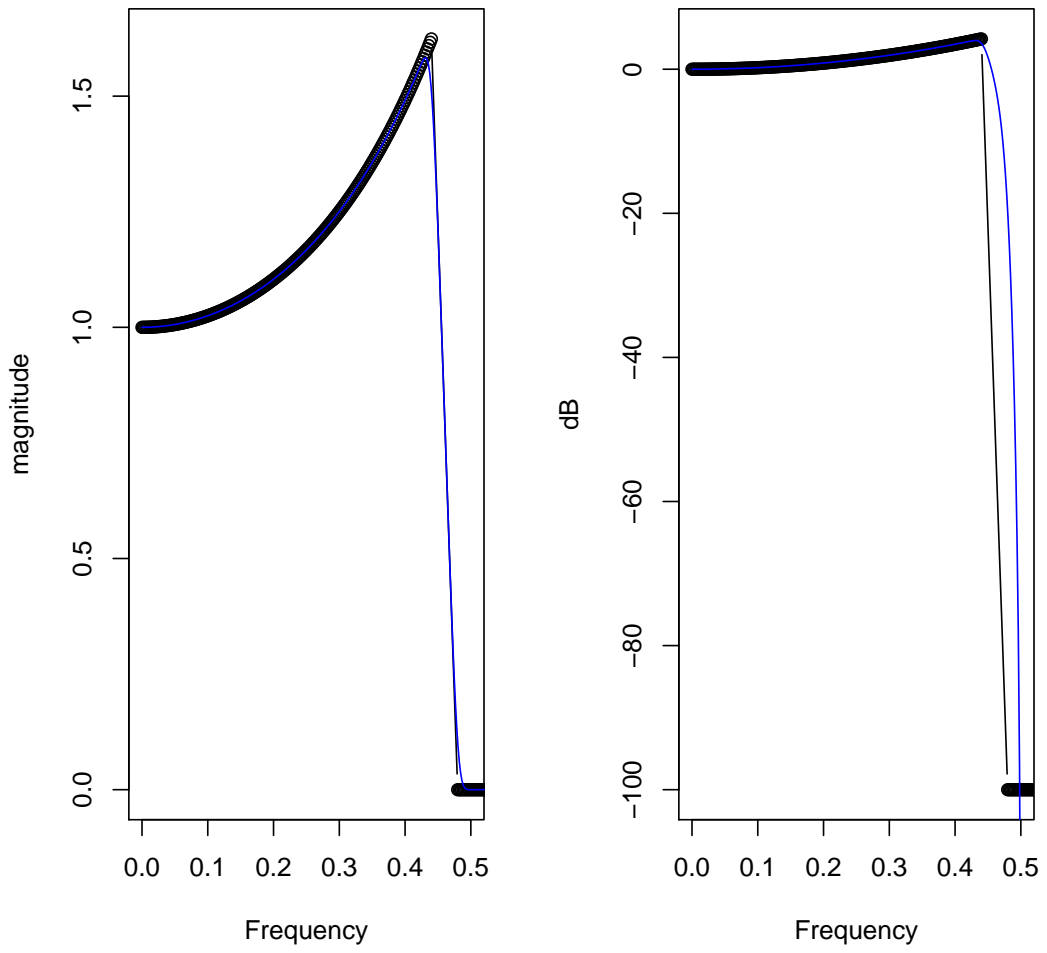
[picture p20: page 1]
Frequency; magnitude
