knifter/pulsednmr/Spice/22MHz Passive Switch and LNA.asc

C1: cap; 150p; Rser=0.1
C2: cap; 350p; Rser=0.1
C3: cap; 150p; Rser=0.1
C4: cap; 1n
C5: cap; 100n
C6: cap; 1µ
C7: cap; 1µ
C8: cap; 1µ
D1: diode; 1N4148
D2: diode; 1N4148
D3: diode; 1N4148
D4: diode; 1N4148
D5: diode; 1N4148
J1: njf; LS5912C
L1: ind; 360n; Rser=0.3
L2: ind; 1µ5; Rser=0.3
L3: ind; 1µ5; Rser=0.3
L4: ind; 1µ5; Rser=0.3
L5: ind; 1µ5; Rser=0.3
R1: res; 10Meg
R2: res; 50
R3: res; 10Meg
R4: res; 50
R5: res; 5
R6: res; 1k
R7: res; 50
V1: voltage; ""; AC 1
V2: voltage; 15
Named nets: 0, RF_PA
.ac dec 100k 10 100Meg
