knifter/pulsednmr/Spice/22MHz Passive Switch.asc

C1: cap; 140p; Rser=0.1
C2: cap; 140p; Rser=0.1
C3: cap; 350p; Rser=0.1
D1: diode; 1N4148
D2: diode; 1N4148
D3: diode; 1N4148
D4: diode; 1N4148
D5: diode; 1N4148
D6: diode; 1N4148
L1: ind; 360n; Rser=0.3
L2: ind; 1µ8; Rser=0.3
L3: ind; 1µ8; Rser=0.3
R1: res; 10Meg
R2: res; 50
R3: res; 10Meg
R4: res; 50
V1: voltage; ""; AC 1
Named nets: 0, RF_PA
.ac dec 100k 10 100Meg
HSMS-2822-TR1G
HSMS-2822-TR1G
D3/D4: MBRS1100T3 or STPS1L30U
