knifter/pulsednmr/Spice/2M7 Passive Switch Danny.asc

C1: cap; 1n2; Rser=0.1
C2: cap; 4n7; Rser=0.1
C3: cap; 1n2; Rser=0.1
D1: diode; 1N4148
D2: diode; 1N4148
D3: diode; 1N4148
D4: diode; 1N4148
L1: ind; 2µ8; Rser=0.3
L2: ind; 11µ2; Rser=0.3
L3: ind; 11µ2; Rser=0.3
R1: res; 10Meg
R2: res; 50
R3: res; 50k
R4: res; 50
V1: voltage; ""; AC 1
Named nets: 0, RF_PA
.ac dec 100k 10 100Meg
