knifter/pulsednmr/Spice/Pickup 2016.asc

C1: cap; 180p
C2: cap; 1p
C3: cap; 1p
L1: ind; 4.4µ
R1: res; 100000k
V1: voltage; SINE(); AC 1; Rser=50
Named nets: 0
.ac lin 1000 1 20meg
