knifter/pulsednmr/Spice/SeriesRLC-SeriesR.asc

C1: cap; {Cs}
C2: cap; {Cp}; Rser=0.1
L1: ind; 1.119µ; Rser=0.1 Cpar=38f
R1: res; 50
V1: voltage; SINE(); AC 1; Rser=0
Named nets: 0, Ucoil, Uin
.ac dec 1000 1Meg 150Meg
.step param X 2p 25p 1p
.param Cs={X}
.param Cp=25p
