knifter/pulsednmr/Vitis/nmr-server/src/main.cpp

#include <stdio.h>
#include <stdlib.h>
#include <stdint.h>
#include <string.h>
#include <unistd.h>
#include <fcntl.h>
#include <math.h>
#include <sys/mman.h>
#include <sys/socket.h>
#include <netinet/in.h>
#include <arpa/inet.h>
#include <errno.h>

#include "config.h"
#include "log.h"
#include "nmrcore.h"
#include "nmr.h"

int run_server();
int handleConnection(int sock_client);

NMRCore* nmr = NULL;

int main(int argc, char *argv[])
{

	LOG("NMR Server Daemon version %s\n", VERSION);

	nmr = new NMRCore();
	// Set some defaults
	// nmr->configure_fclk0();
	nmr->setFrequency(20E6);
	nmr->setRxRate(RATE_2500K);
	nmr->setRxSize(50000);
	nmr->setRxDelay(0);

	nmr->setTxBlankLen(50);
	nmr->setTxAlen(15);
	nmr->setTxBlen(8);
	nmr->setTxABdly(1500);
	nmr->setTxBBdly(1500);
	nmr->setTxBBcnt(0);
	nmr->setTxPower(PULSE_POWER_MAX);

	int res = EXIT_SUCCESS;
	bool flag_run_server = true;
	int c;
	while( (c = getopt(argc, argv, "f:nrp:s:t"))  != -1)
	{
		switch(c)
		{
			case 'f': // optarg
			{
				int freq = atoi(optarg);
				LOG("Force-on: Pulse output on (f = %d Hz. Press key to stop..", freq);
				flag_run_server = false;
				nmr->setFrequency(freq);
				nmr->forceOn(true);
				getchar();
				nmr->forceOn(false);
			}; 	break;
			case 'n':
				flag_run_server = false;
				break;
			case 'r':
				nmr->reset_pl(); // Will crash 2nd time, dunno why
				break;
			case 'p': 
			{
				uint16_t power = (int) (atoi(optarg)*65535/100);
				LOG("SetTxPower(%u)\n", power);
				nmr->setTxPower(power);
			}; 	break;
			case 's': // optarg
			{
				flag_run_server = false;
				int test_pulse_count = atoi(optarg);
				LOG("Sending %d test pulses.\n", test_pulse_count);
				while(test_pulse_count--)
				{
					LOG("Sending test pulse...\n");
					nmr->singleShot();

					usleep(5E5);
				};
			};	break;
			case 't': // optarg
			{
				LOG("Running test-function. Press ctrl-c to stop..\n");
				nmr->TestFunction();
				flag_run_server = false;
			}; 	break;

			case '?': // unknown option
				DBG("Unknown");
				break;
			default:
				DBG("HERE\n");
				flag_run_server = false;
				res = EXIT_FAILURE;
				break;
		};
	};
	
	if(flag_run_server)
	{
	 	res = run_server();
	};

	delete nmr;
	return res;
};

int run_server()
{
	LOG("Starting TCP server on port %d\n", SERVER_PORT);

	// Get a server socket
	int sock_server;
	if((sock_server = socket(AF_INET, SOCK_STREAM, 0)) < 0)
	{
		ERROR("Cannot instantiate server socket: %s\n", strerror(errno));
		// perror(NULL);
		return EXIT_FAILURE;
	};
	int yes = 1;
	setsockopt(sock_server, SOL_SOCKET, SO_REUSEADDR, (void *)&yes , sizeof(yes));

	/* setup listening address */
	struct sockaddr_in addr;
	memset(&addr, 0, sizeof(addr));
	addr.sin_family = AF_INET;
	addr.sin_addr.s_addr = htonl(INADDR_ANY);
	addr.sin_port = htons(SERVER_PORT);
	
	if(bind(sock_server, (struct sockaddr *)&addr, sizeof(addr)) < 0)
	{
		ERROR("Cannot bind server socket: %s\n", strerror(errno));
		return EXIT_FAILURE;
	};


	listen(sock_server, 1024);

	int sock_client;
	while(1)
	{
		LOG("Waiting for connection.\n");
		if((sock_client = accept(sock_server, NULL, NULL)) < 0)
		{
			ERROR("Could not accept socket: %s\n", strerror(errno)); 
			return EXIT_FAILURE;
		};
		if(handleConnection(sock_client))
		{
			LOG("Connection Terminated.");
		};
		close(sock_client);
	}; // while(1) server

	printf("Closing server socket.\n");
	close(sock_server);
	return EXIT_SUCCESS;
};

int handleConnection(int sock_client)
{
	LOG("\nConnection accepted.\n");

	CommandPacket command;
	CommandReply  reply;
	char command_data[MAX_COMMAND_DATA];
	void* reply_data = NULL;
	int res;
	while(1)
	{
		printf(".\n");
		// recv command len
		res = recv(sock_client, &command, sizeof(command), MSG_WAITALL);
		if(res == 0)
		{
			LOG("Remote closed connection.\n");
			return 0;
		};
		if(res < 0)
		{
			ERROR("Read error while reading command: %s\n", strerror(errno));
			return 1;
		};
		if(command.data_len > MAX_COMMAND_DATA)
		{
			ERROR("Command extra data_len too big. Bailing out.\n");
			return 2;
		};

		// read extra data
		if(command.data_len > 0)
		{
			DBG("before recv\n");
			res = recv(sock_client, &command_data, command.data_len, MSG_WAITALL);
			DBG("after recv\n");
			if(res == 0)
			{
				LOG("Remote closed connection.\n");
				return 0;
			};
			if(res < 0)
			{
				ERROR("Read error while reading data_len: %s\n", strerror(errno));
				return 1;
			};
		};

		// prepare the reply
		reply.id = command.id;
		reply.result = RES_UNKNOWN;
		reply.data_len = 0;
		reply_data = NULL;

		// int command = *((int*)pbuf) >> 28;
		// int param = pbuf & 0x0fffffff;
		switch(command.commandcode)
		{
			case CMD_SET_FREQ:
				LOG("Set Freq %d\n", command.param);
				reply.result = nmr->setFrequency(command.param) ? RES_ERROR : RES_OK;
				break;
			case CMD_SET_RATE:
				reply.result = nmr->setRxRate((NMRDecimationRate) command.param) ? RES_ERROR : RES_OK;
				LOG("Set Rx SampleRate #%d: %d ksps.\n", command.param, (int)(nmr->getRxRate()/1E3));
				break;
			case CMD_SET_AWIDTH:
				LOG("Set A-Width %d usec.\n", command.param);
				reply.result = nmr->setTxAlen(command.param) ? RES_ERROR : RES_OK;
				break;
			case CMD_SET_BWIDTH:
				LOG("Set B-Width %d usec.\n", command.param);
				reply.result = nmr->setTxBlen(command.param) ? RES_ERROR : RES_OK;
				break;
			case CMD_SET_ABDLY:
				LOG("Set AB-Delay %d usec.\n", command.param);
				reply.result = nmr->setTxABdly(command.param) ? RES_ERROR : RES_OK;
				break;
			case CMD_SET_BBDLY:
				LOG("Set BB-Delay %d usec.\n", command.param);
				reply.result = nmr->setTxBBdly(command.param) ? RES_ERROR : RES_OK;
				break;
			case CMD_SET_BBCNT:
				LOG("Set B-Count %d usec.\n", command.param);
				reply.result = nmr->setTxBBcnt(command.param) ? RES_ERROR : RES_OK;
				break;
			case CMD_FIRE:
				LOG("SingleShot.\n");
				if(nmr->singleShot())
				{
					ERROR("singleShot failed.");
					reply.result = RES_ERROR;
					break;
				};
				if(nmr->getRxBuffer(&reply_data, &(reply.data_len)))
				{
					ERROR("Failed to get RxBuffer from NMR Core.\n");
					reply.result = RES_ERROR;
					break;
				}
				reply.result = RES_OK;
				break;
			case CMD_SET_RX_SIZE:
				LOG("Set Rx Size %d\n", command.param);
				reply.result = nmr->setRxSize(command.param) ? RES_ERROR : RES_OK;
				break;
			case CMD_SET_RX_DELAY:
				LOG("Set Rx Delay %d\n", command.param);
				reply.result = nmr->setRxDelay(command.param) ? RES_ERROR : RES_OK;
				break;
			case CMD_KEEPALIVE:
				LOG("Keep-Alive packet received.\n");
				reply.result = RES_OK;
				break;
			case CMD_SET_POWER:
				LOG("Set Power %d\n", command.param);
				reply.result = nmr->setTxPower(command.param) ? RES_ERROR : RES_OK;
				break;
			case CMD_SET_BLANKLEN:
				LOG("Set Blank Length %d usec.\n", command.param);
				reply.result = nmr->setTxBlankLen(command.param) ? RES_ERROR : RES_OK;
				break;
            case CMD_SET_AMP:
                LOG("Set Amplifier %d\n", command.param);
                reply.result = nmr->ampOn(command.param) ? RES_ERROR : RES_OK;
                break;
			default:
				WARNING("Unknown command code: %d\n", command.commandcode);
				break;
		}; // switch(command)

		// send reply
		DBG("Sending reply packet (id = %u, result = %u, data_len = %u)\n", reply.id, reply.result, reply.data_len);
		send(sock_client, &reply, sizeof(reply), MSG_NOSIGNAL);
		if(reply.data_len)
			send(sock_client, reply_data, reply.data_len, MSG_NOSIGNAL);
	};
	return 0;
};
