knifter/pulsednmr/Vitis/nmr-server/src/nmrcore.cpp

#include "nmrcore.h"
#include "config.h"

#include "log.h"

#include <stdio.h>
#include <stdint.h>
#include <stdlib.h>
#include <fcntl.h>
#include <unistd.h>
#include <string.h>
#include <math.h>
#include <sys/mman.h>
#include <sys/time.h>
#include <errno.h>

#define MEM_DEVICE			"/dev/mem"
#define MMAP_SLCR					0xF8000000		// ?
	#define SLCR_LOCK					0x0004
	#define SLCR_UNLOCK					0x0008
  	#define SLCR_LOCK_KEY				0x767B
  	#define SLCR_UNLOCK_KEY				0xDF0D
	#define SLCR_FPGA0_CLK_CTRL			0x005C // was: 92
	#define	SLCR_FPGA_RST_CTRL			0x0240
#define MMAP_RXCONFIG 				0x40000000
	#define RXCONFIG_NONE				0x00
	#define RXCONFIG_RESET_DDS 			0x01
	#define RXCONFIG_RESET_TX 			0x02
	#define RXCONFIG_RESET_FIFO			0x04
	#define RXCONFIG_AMP_ON 			0x40
	#define RXCONFIG_FORCE_ON			0x80
#define MMAP_RXSTATUS 				0x40001000
#define MMAP_TXCONFIG 				0x40002000
#define MMAP_RXDATA 				0x40010000
#define DAC_SAMPLE_RATE     		125000000		// 125 MSPS
#define FIR_RATE					2
// #define CIC_RATE_MIN				25
// #define CIC_RATE_MAX				625
//#define TX_BUFSIZE          50000           // Configures buffer size (PL)
#define RX_DDS_PIR_WIDTH	30				// bit-width of DDS Phase register
#define TX_DDS_PIR_WIDTH	30				// bit-width of DDS Phase register
// #define NMR_PG_CLK			(NMR_CORE_CLK / 14.0)

uint32_t max(uint32_t a, uint32_t b)
{
	if(a>b)
		return a;
	return b;
};

NMRCore::NMRCore()
{
	// Memory Map PL Registers
	if((_map_fd = open(MEM_DEVICE, O_RDWR)) < 0)
	{
		ERROR("ERROR: opening mem-device\n");
		return;
	};
	_slcr = (uint32_t*) mmap(NULL, sysconf(_SC_PAGESIZE), PROT_READ|PROT_WRITE, MAP_SHARED, _map_fd, MMAP_SLCR);
	_rxconfig = (PL_RxConfigRegister*) mmap(NULL, sysconf(_SC_PAGESIZE), PROT_READ|PROT_WRITE, MAP_SHARED, _map_fd, MMAP_RXCONFIG);
	_rxstatus =   (PL_RxStatusRegister*) mmap(NULL, sysconf(_SC_PAGESIZE), PROT_READ|PROT_WRITE, MAP_SHARED, _map_fd, MMAP_RXSTATUS);
	_txconfig = (PL_TxConfigRegister*) mmap(NULL, sysconf(_SC_PAGESIZE), PROT_READ|PROT_WRITE, MAP_SHARED, _map_fd, MMAP_TXCONFIG);
	_map_rxdata = (volatile uint64_t*) mmap(NULL, 16*sysconf(_SC_PAGESIZE), PROT_READ|PROT_WRITE, MAP_SHARED, _map_fd, MMAP_RXDATA);
  	// sysconf(_SC_PAGESIZE) = 4096, 16*=65536 bytes
  	if(_slcr == NULL)
  	{
  		ERROR("mmap(SLCR) failed.\n");
  		return;
  	};
  	if(_rxconfig == NULL)
  	{
  		ERROR("mmap(RXCONFIG) failed.\n");
  		return;
  	};
  	if(_rxstatus == NULL)
  	{
  		ERROR("mmap(TXSTATUS) failed.\n");
  		return;
  	};
  	if(_txconfig == NULL)
  	{
  		ERROR("mmap(TXCONFIG) failed.\n");
  		return;
  	};
  	if(_map_rxdata == NULL)
  	{
  		ERROR("mmap(RXDATA) failed.\n");
  		return;
  	};

  	// Alignment checking
#ifdef DEBUG_ALIGNMENT
	printf("RxConfig at: %p\n", _rxconfig);
	printf("\treset: %p\n", &(_rxconfig->reset));
	printf("\trate: %p\n", &(_rxconfig->rate));
	printf("\tpir: %p\n", &(_rxconfig->pir));
	printf("SizeOf(PL_ConfigRxRegister: %d\n", sizeof(*_rxconfig));

	printf("TxConfig at: %p\n", _txconfig);
	printf("\tpir: %p\n", &(_txconfig->pir));
	printf("\talen: %p\n", &(_txconfig->a_len));
	printf("\tbleb: %p\n", &(_txconfig->b_len));
	printf("\tabdly: %p\n", &(_txconfig->ab_dly));
	printf("\tbbdly: %p\n", &(_txconfig->bb_dly));
	printf("\tbbcnt: %p\n", &(_txconfig->bb_cnt));
	printf("\tpwrout: %p\n", &(_txconfig->pwrout));
	printf("\tblanklen: %p\n", &(_txconfig->blank_len));
	printf("SizeOf(PL_ConfigTxRegister: %d\n", sizeof(*_txconfig));
#endif

    // Align the DDS's, keep the transmitter in reset
    _rxconfig->control = RXCONFIG_NONE;
};

NMRCore::~NMRCore()
{
	if(_map_fd)
		close(_map_fd);
	_rxconfig = NULL;

	_rxstatus = NULL;
	_txconfig = NULL;
};

int NMRCore::TestFunction()
{
	setFrequency(10E6);

	// FIXME: test read
	int n = 1000;
	DBG("Toggling Resets.");
	while(n--)
	{
		Reset();
		usleep(1000);
	};
	return 0;

	// usleep(100E3);
	n = 100;
	uint64_t sample;
	DBG("Starting testread of %d samples. %d 32b words waiting in FIFO now.\n", n, _rxstatus->rx_counter);
	while(n)
	{		
		if(_rxstatus->rx_counter > 1)
		{
			sample = *_map_rxdata;
			DBG("Read (%u) I/Q F: %0.2f / %0.2f \n", _rxstatus->rx_counter, (float) (sample & 0xFFFFFFFF), (float) (sample >> 32));
			DBG("Read (%u) I/Q x: %08x / %08x \n", _rxstatus->rx_counter, (int32_t)(sample & 0xFFFFFFFF), (int32_t)(sample >> 32));
			DBG("Read (%u) I/Q I: %d / %d \n", _rxstatus->rx_counter, (int32_t)(sample & 0xFFFFFFFF), (int32_t)(sample >> 32));

			n--;
		};
	};

	return 0;
};

int NMRCore::configure_fclk0()
{
  	// Configure FCLK0 (143 MHz)
  	printf("Configuring PLL for 143 MHz.\n");

  	// Unlock SLCR
   	_slcr[SLCR_UNLOCK] 		= SLCR_UNLOCK_KEY; // @=8, SLCR_UNLOCK

  	// FPGA0_CLK_CTRL:
  	// 	31:26, 6 = 0
  	// 	25:20, 6 = DIVISOR1
  	// 	19:14, 6 = 0
  	// 	13:08, 6 = DIVISOR0
  	// 	07:06, 2 = 0
  	// 	05:04, 2 = SRCSEL: 0x: IO PLL, 10: ARM PLL, 11: DDR PLL
  	// 	03:00, 4 = 0
  	_slcr[SLCR_FPGA0_CLK_CTRL] 	= (_slcr[SLCR_FPGA0_CLK_CTRL] & ~0x03F03F30) | 0x00100700;

  	// Lock SLCR
  	// _slcr[SLCR_LOCK] 		= SLCR_LOCK_KEY;

  	return 0;
};

int NMRCore::reset_pl()
{
  	// Unlock SLCR
  	printf("Unlock SLCR.\n");
   	_slcr[SLCR_UNLOCK] 		= SLCR_UNLOCK_KEY; // @=8, SLCR_UNLOCK

   	// Toggle reset
  	printf("Reset PL.\n");
  	_slcr[SLCR_FPGA_RST_CTRL] = 0x00;
  	usleep(80E3); // 80 ms, about what an upload bit file does
  	printf("Un-Reset PL.\n");
  	_slcr[SLCR_FPGA_RST_CTRL] = 0x00;

  	// Lock SLCR
  	// printf("Lock SLCR.\n");
  	// _slcr[SLCR_LOCK] 		= SLCR_LOCK_KEY;

  	return 0;
};

int NMRCore::setFrequency(uint32_t freq)
{
	int res = setRxFrequency(freq);
	if(res)
		return res;
	return setTxFrequency(freq);
};

int NMRCore::setRxFrequency(uint32_t freq)
{
	if(!_rxconfig)
	{
		ERROR("setRxFrequency: _rxconfig == NULL\n");
		return 1;
	};
	if((freq < FREQ_MIN) | (freq > FREQ_MAX))
	{
		ERROR("setRxFrequency: Rx Freq out of range.\n");
		return 2;
	};

	uint32_t pir = floor((float)freq / DAC_SAMPLE_RATE * (1<<RX_DDS_PIR_WIDTH) + 0.5);
	DBG("%u Hz -> DDS phase-incr-reg: %u\n", freq, pir);
	_rxconfig->pir = pir;

	return 0;
};

int NMRCore::setTxFrequency(uint32_t freq)
{
	if(!_txconfig)
	{
		ERROR("_txconfig == NULL\n");
		return 1;
	};
	if((freq < FREQ_MIN) | (freq > FREQ_MAX))
	{
		ERROR("Tx Freq out of range.");
		return 2;
	};

	uint32_t pir = floor((float)freq / DAC_SAMPLE_RATE * (1<<TX_DDS_PIR_WIDTH) + 0.5);
	DBG("%u Hz -> DDS phase-incr-reg: %u\n", freq, pir);
	_txconfig->pir = pir;

	return 0;
}

int NMRCore::setTxAlen(uint32_t usec)
{
	if(!_txconfig)
	{
		ERROR("_txconfig == NULL\n");
		return 1;
	};
	if((usec > PULSE_LEN_MAX) | (usec < PULSE_LEN_MIN))
	{
		ERROR("A-length %u out of range (%d, %d)\n", usec, PULSE_LEN_MIN, PULSE_LEN_MAX);
		return 2;
	};

	DBG("A-length: %u usec pulse.\n", usec);

	_txconfig->a_len = usec;

	// make sure BlankLen doesn't cut out our pulse
	setTxBlankLen(_txconfig->blank_len);

	return 0;
};

int NMRCore::setTxBlen(uint32_t usec)
{
	if(!_txconfig)
	{
		ERROR("_txconfig == NULL\n");
		return 1;
	};
	if((usec > PULSE_LEN_MAX) | (usec < PULSE_LEN_MIN))
	{
		ERROR("B-length %u out of range (%d, %d)\n", usec, PULSE_LEN_MIN, PULSE_LEN_MAX);
		return 2;
	};

	DBG("B-length: %u usec pulse.\n", usec);

	_txconfig->b_len = usec;

	// make sure BlankLen doesn't cut out our pulse
	setTxBlankLen(_txconfig->blank_len);

	return 0;
};

int NMRCore::setTxABdly(uint32_t usec)
{
	if(!_txconfig)
	{
		ERROR("_txconfig == NULL\n");
		return 1;
	};
	if((usec > PULSE_DLY_MAX) | (usec < PULSE_DLY_MIN))
	{
		ERROR("A-to-B-Delay %u out of range (%d, %d)\n", usec, PULSE_DLY_MIN, PULSE_DLY_MAX);
		return 2;
	};

	DBG("A-to-B-Delay: %u usec.\n", usec);

	_txconfig->ab_dly = usec;

	// make sure BlankLen doesn't cut out our pulse
	setTxBlankLen(_txconfig->blank_len);

	return 0;
};

int NMRCore::setTxBBdly(uint32_t usec)
{
	if(!_txconfig)
	{
		ERROR("_txconfig == NULL\n");
		return 1;
	};
	if((usec > PULSE_DLY_MAX) | (usec < PULSE_DLY_MIN))
	{
		ERROR("B-to-B-Delay %u out of range (%d, %d)\n", usec, PULSE_DLY_MIN, PULSE_DLY_MAX);
		return 2;
	}

	DBG("B-to-B-Delay: %u usec.\n", usec);

	_txconfig->bb_dly = usec;

	// make sure BlankLen doesn't cut out our pulse
	setTxBlankLen(_txconfig->blank_len);

	return 0;
};

int NMRCore::setTxBBcnt(uint32_t count)
{
	if(!_txconfig)
	{
		ERROR("_txconfig == NULL\n");
		return 1;
	};
	if((count > PULSE_BCNT_MAX) | (count < PULSE_BCNT_MIN))
	{
		ERROR("B-Count %u out of range (%d, %d)\n", count, PULSE_BCNT_MIN, PULSE_BCNT_MAX);
		return 2;
	};

	DBG("B-Count: %u pulses.\n", count);

	_txconfig->bb_cnt = count;

	return 0;
};

int NMRCore::setTxPower(uint16_t power)
{
	if(!_txconfig)
	{
		ERROR("_txconfig == NULL\n");
		return 1;
	};
	if((power > PULSE_POWER_MAX) | (power < PULSE_POWER_MIN))
	{
		ERROR("Power-out %u out of range (%d, %d)\n", power, PULSE_POWER_MIN, PULSE_POWER_MAX);
		return 2;
	};

	DBG("Power-out multiplier: %u\n", power);

	_txconfig->power_out = (uint16_t) power;

	return 0;
};

int NMRCore::setTxBlankLen(uint32_t usec)
{
	if(!_txconfig)
	{
		ERROR("_txconfig == NULL\n");
		return 1;
	};
	if((usec > BLANK_LEN_MAX) | (usec < BLANK_LEN_MIN))
	{
		ERROR("Blank-len %u out of range (%d, %d)\n", usec, BLANK_LEN_MAX, BLANK_LEN_MIN);
		return 2;
	};
	if(usec > (_txconfig->ab_dly - _txconfig->a_len  - BLANK_RECOVER_US))
	{
		usec = max(0, _txconfig->ab_dly - _txconfig->a_len - BLANK_RECOVER_US);
		WARNING("Blank-len > end of A to to begin of B pulse. Truncated to %d usec\n", usec);
	};
	if(usec > (_txconfig->bb_dly - _txconfig->b_len  - BLANK_RECOVER_US))
	{
		usec = max(0, _txconfig->bb_dly - _txconfig->b_len - BLANK_RECOVER_US);
		WARNING("Blank-len > end of B to to begin of next B pulse. Truncated to %d used.\n", usec);
	};

	DBG("Blank length: %u usec\n", usec);

	_txconfig->blank_len = usec;

	return 0;
};

int NMRCore::setRxRate(NMRDecimationRate idx)
{
	if(!_rxconfig)
	{
		ERROR("setRxRate: _rxconfig == NULL\n");
		return 1;
	};
	// rx_rate = DAC_SAMPLE_RATE / divider / 2 [CIC(rx_rate) + FIR(2)]
	int smps = 25E3;
	switch(idx)
	{
		// DAC_SAMPLE_RATE / 2500 = 50ksmps
		case RATE_25K:
			smps = 25E3;
			break;
		case RATE_50K:
			smps = 50E3;
			break;
		case RATE_125K:
			smps = 125E3;
			break;
		case RATE_250K:
			smps = 250E3;
			break;
		case RATE_500K:
			smps = 500E3;
			break;
		case RATE_1250K:
			smps = 1250E3;
			break;
		case RATE_2500K:
			smps = 2500E3;
			break;
		default: 
			ERROR("Received an incorrect rate-index: %d\n", idx);
			return 1;
	};

	// Calc actual cic rate config value & write it
	int cic_rate = DAC_SAMPLE_RATE/FIR_RATE / smps;
	DBG("setRxRate: idx = %d: %d ksmps, cic_rate = %d\n", idx, (int)(smps/1E3), cic_rate);
	_rxconfig->rate = cic_rate;

	return 0;
};

int NMRCore::getRxRate()
{
	 return DAC_SAMPLE_RATE / (2*_rxconfig->rate);
};

int NMRCore::setRxSize(uint32_t size)
{
	if(_rx_buffer)
		free(_rx_buffer);

	// We need <size> complex floats
	uint32_t bsize = size * 2 * sizeof(float);
	DBG("Reserving %u bytes for a %u sample Rx Buffer.\n", bsize, size);
	_rx_buffer = (uint64_t*) malloc(bsize);
	if(_rx_buffer == NULL)
	{
		ERROR("Failed to allocate RxBuffer of %u bytes for %u samples.", bsize, size);
		_rx_size = 0;
		return 1;
	}
	_rx_size = size;

	return 0;
};

int NMRCore::setRxDelay(uint32_t usec)
{
	if(!_rxconfig)
	{
		ERROR("_rxconfig == NULL\n");
		return 1;
	};
	if((usec > RX_DELAY_MAX) | (usec < RX_DELAY_MIN))
	{
		ERROR("Rx-Delay %u clks out of range (%d, %d)\n", usec, RX_DELAY_MIN, RX_DELAY_MAX);
		return 2;
	}
	// uint32_t usec = (float)clks * 1E6 / NMR_PG_CLK;
	uint32_t samples = ((uint64_t)getRxRate() * (uint64_t)usec) / 1E6;
	DBG("Rx-Delay %u us, %u samples.\n", usec, samples);
	_rx_delay = samples;

	return 0;
};

int NMRCore::forceOn(bool on)
{
	if(!_rxconfig)
	{
		DBG("forceOn: _rxconfig == NULL\n");
		return 1;
	};

	if(on)
		_rxconfig->control |= RXCONFIG_FORCE_ON;
	else
		_rxconfig->control &= ~(RXCONFIG_FORCE_ON);
	return 0;
};

int NMRCore::ampOn(bool on)
{
    if(!_rxconfig)
    {
		DBG("ampOn: _rxconfig == NULL\n");
		return 1;
    }

    if(on)
        _rxconfig->control |= RXCONFIG_AMP_ON;
    else
        _rxconfig->control &= ~(RXCONFIG_AMP_ON);
    return 0;
}

int NMRCore::Reset()
{
	if(!_rxconfig)
	{
		DBG("singleShot: _rxconfig == NULL\n");
		return 1;
	};

	DBG("Reset: TX DDS FIFO\n");	
	_rxconfig->control |= RXCONFIG_RESET_DDS | RXCONFIG_RESET_FIFO | RXCONFIG_RESET_TX; 
	// _rxconfig->control = RXCONFIG_RESET_TX;
	_rxconfig->control &= ~(RXCONFIG_RESET_DDS | RXCONFIG_RESET_FIFO | RXCONFIG_RESET_TX); 
	
	// usleep(500);

	return 0;
};

int NMRCore::singleShot()
{

	if(!_rxconfig)
	{
		DBG("singleShot: _rxconfig == NULL\n");
		return 1;
	};
	if(!_rx_buffer)
	{
		ERROR("No Rx buffer allocated.\n");
		return 2;
	};

	// Pulse sequence is automatically started after reset
	DBG("Start Tx.\n");
	Reset();

	// Discard _rxdelay samples
	if(_rx_delay)
	{
#ifdef DEBUG_READLOOP
		DBG("Start RxDelay: discarding %u samples.\n", _rx_delay);
#endif // DEBUG_READLOOP
		int32_t needed = _rx_delay;
		uint64_t dummy = 0;
		dummy = dummy; // unused supression
		uint32_t check = 0;
		while(needed)
		{
			// throttle polling
			while(_rxstatus->rx_counter < 1000)
				usleep(100);
			
			// rx_counter is our total number of floats waiting, twice the amount of samples
			// read it once and cache it locally, it's updated by the PL
			int len = _rxstatus->rx_counter >> 1;

			// There is probably more in the fifo then we need at some point
			if(len > needed)
				len = needed;
		#ifdef DEBUG_READLOOP
			DBG(" ... %u/%u/%u samples.\n", len, needed, _rx_delay);
		#endif // DEBUG_READLOOP

			// discard fifo values by reading into a dummy
		    for(int j = 0; j < len; ++j)
		    {
		    	dummy = *_map_rxdata;
		    };

			needed -= len;
			check += len;
		};
		DBG("RxDelay: Discarded %u samples.\n", check);
	};

	DBG("Start Rx.\n");
	// Get FIFO data into buffer
	{
#ifdef DEBUG_READLOOP
		DBG("read loop start\n");
		struct timeval tv;
		gettimeofday(&tv,NULL);
		uint64_t start = 1E6*tv.tv_sec + tv.tv_usec;
		int idle_cnt = 5000; // 500ms
#endif // DEBUG_READLOOP

		// Read rx_size samples into rxbuffer
		uint32_t rx_total = 0;
		while(rx_total < _rx_size)
		{
			// throttle polling
			while(_rxstatus->rx_counter < 10000)
			{
#ifdef DEBUG_READLOOP
				if(idle_cnt--<1)
				{
					idle_cnt = 5000;
					DBG("Waiting for 10k samples (rx_counter = %d)\n", _rxstatus->rx_counter);
				};
#endif
				usleep(100);
			};

			// rx_counter is our total number of floats waiting, twice the amount of samples
			// read it once and cache it locally, it's updated by the PL
			int len = _rxstatus->rx_counter >> 1;

			// now len is the amount of 'samples', complex floats waiting (even)
			int needed = _rx_size - rx_total;
#ifdef DEBUG_READLOOP
			DBG("%d float pairs waiting. %d still needed.\n", len, needed);
#endif
			if(len > needed)
				len = needed;
	    	for(int j = 0; j < needed; ++j) 
	    	{
	     		_rx_buffer[j] = *_map_rxdata;
	     	};
			rx_total += len;
		};
#ifdef DEBUG_READLOOP
		gettimeofday(&tv,NULL);
		uint64_t stop = 1E6*tv.tv_sec + tv.tv_usec;
		uint32_t tim = stop - start;
		DBG("read loop done. Time = %u, Rate > %.0f smps\n", tim, rx_total*(1.0E6/tim) );
#endif // DEBUG_READLOOP


		DBG("Total %d complex-floats read. %d Bytes.\n", rx_total, rx_total*2*sizeof(float));
	};

	// // Keep the Tx in reset
	// _rxconfig->control = RXCONFIG_RESET_TX;

	return 0;
};

int NMRCore::getRxBuffer(void** data_target, uint32_t* len_target)
{
	if(_rx_size == 0)
	{
		ERROR("No RxBuffer size. Nothing to return.\n");
		return 1;
	}
	if(!_rx_buffer)
	{
		ERROR("No Rx buffer allocated.\n");
		return 2;
	};

	*data_target = _rx_buffer;
	*len_target = _rx_size * 2 * sizeof(float);
	return 0;
};
