knifter/pulsednmr/(commit log)

2016-11-25 [CHG] Check RxTxOffset [ADD] absolute frequency in FFTWidget [FIX] set_rate vs set_rxTime vs rxSize amount of samples fixed [FIX] set UI Default values with update on startup (set create values to 9'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
2016-11-29 [ADD] Acquisition Delay [ADD] keep-alive command implemented (not used) [FIX] Removed \n at end of log lines [CHG] CamelCase method names in Plotwidgets [DEL] Removed mode_1,2,3 in mainwindow.py [ADD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
    [main.cpp, nmr.h, nmrcore.cpp, nmrcore.h]
2016-12-05 Client: [CHG] TimePlot: rescale Y depending on I/Q/A mode [ADD] Added vertical cursor line to FFTPlot [CHG] Changed pulsegen parameter limits as talked through with Tom [FIX] Disabled Start button on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
2016-12-06 HDL: [FIX] Solved warning about LFSR width [CHG] LFSR changed output width [FIX] Solved STS register width with rd_len from fifo (Concat added) [CHG] Implemented streaam splitting and combining for A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
2016-12-21 NMRClient: Added Batchfile and Shortcut to initialize python environment
    NMR Server:
    Print welcome message first before nmrcore init
    [main.cpp]
2016-12-27 nmr-server: [ADD] Configure FPGA FCLK0 from C-code in server (untested) [FIX] Changed readloop to uint64_t without memcpy, fixed the sample glitches [FIX] changed constant definitions to not contain 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
    [nmrcore.cpp]
2016-12-27 nmr-server: [FIX] headerfile changes for previous fix
    [nmrcore.h]
2017-01-02 HDL: [FIX] AXIS_FIFO now connects fifo_full/empty with tvalid/tready
    [axis_fifo.v]
2019-05-17 Add 3D files for Switch box
    [PassiveSwitchCase.ipt]
2019-05-20 Add output power control
2019-05-22 Cap the powerfactor at 2^16
2019-05-29 Impl. reset_rx became reset_dds'
    [config.h, nmrcore.cpp]
2021-05-17 new ADC/DAC cores: 16-bit adc & phase-clocked DAC
2021-07-12 stylefix, add pl reset method, move config fclk to method, fix SLCR_UNLOCK register address
    [nmrcore.cpp, nmrcore.h]
2021-07-13 RP schematic
2021-07-23 remove old RP adc/dac cores from localcores (in cores now)
2021-08-02 PL updates: DMA (only added), update sts_reg, reader, dds width, see CHANGELOG
2021-08-03 nmrserver: reset dds & fifo as well
    [nmrcore.cpp, nmrcore.h]
2021-08-24 powerout, 125 MHz
2021-08-26 replaced lfsr, order of io pin funcs
2021-09-01 Fixed chain from ADC to Mixer
2021-10-05 Removed DMA test and manual fabric reset
2021-10-27 Fixed dBm calculation for output power
